thanasipantazides/tate-thermovac/build/tvac-bom-order.xlsx

Designator | Footprint | Quantity | Value | DNP | Manufacturer | MPN | Distributor | DPN
A2 | Hirose_DF40HC(3.0)-100DS-0.4V_2x50_P0.4mm_RPi_CM4-BUS | 1 | Raspberry_Pi_CM4-BUS |  | Hirose | DF40HC(3.0)-100DS-0.4V(58) | Digikey | H124602CT-ND
A3 | Hirose_DF40HC(3.0)-100DS-0.4V_2x50_P0.4mm_RPi_CM4-GPIO | 1 | Raspberry_Pi_CM4-GPIO |  | Hirose | DF40HC(3.0)-100DS-0.4V(58) | Digikey | H124602CT-ND
C2, C28 | C_1210_3225Metric | 2 | 10µF (X5R) |  | YAGEO | CC1210KFX7R8BB106 | Digikey | 13-CC1210KFX7R8BB106CT-ND
C1, C3, C4, C30, C31, C56, C57, C59, C61, C68, C74 | C_0603_1608Metric | 9 | 0.1µF |  | YAGEO | CC0603KRX7R8BB104 | Digikey | 311-1341-1-ND
C5, C32, C54, C70, C71, C75, C76 | C_0603_1608Metric | 7 | 1µF |  | YAGEO | CC0603MRX5R8BB105 | Digikey | 311-1823-1-ND
C6, C33, C58, C64, C65, C66 | C_1210_3225Metric | 6 | 10µF |  | YAGEO | CC1210MKX7R8BB106 | Digikey | 311-3469-1-ND
C7, C29 | C_1210_3225Metric | 2 | 10µF (X7R) |  | YAGEO | CC1210MKX7R8BB106 | Digikey | 311-3469-1-ND
C8, C9, C10, C11, C12, C13, C14, C15, C16, C17, C18, C19, C20, C21, C22, C23, C24, C25, C26, C27, C34, C35, C36, C37, C38, C39, C40, C41, C42, C43, C44, C45, C46, C47, C48, C49, C50, C51, C52, C53 | C_0603_1608Metric | 40 | 100pF |  | YAGEO | CC0603KRX7R8BB101 | Digikey | 311-4078-1-ND
C55 | C_0603_1608Metric | 1 | 1nF |  | YAGEO | CC0603KRX7R9BB102 | Digikey | 311-1080-1-ND
C60 | C_1210_3225Metric | 1 | 100nF, 100V |  | Murata | GRM155R62A104KE14D | Digikey | 490-10458-1-ND
C62 | C_0603_1608Metric | 1 | 4.7pF |  | YAGEO | CC0603CRNPO9BN4R7 | Digikey | 311-1740-1-ND
C63, C69 | C_1210_3225Metric | 2 | 100µF (X5R) |  | Taiyo Yuden | EMK325ABJ107MM-P | Digikey | 587-5426-1-ND
C67 | C_0603_1608Metric | 1 | 330pF |  | YAGEO | CC0603KRX7R9BB331 | Digikey | 311-1186-1-ND
D1 | LED_1206_3216Metric | 1 | GREEN |  | Kingbright | APT3216SGC | Digikey | 754-1141-1-ND
D2 | LED_1206_3216Metric | 1 | RED |  | Kingbright | APT3216SECK/J3-PRV | Digikey | 754-1796-1-ND
D3 | SOT-23 | 1 | MMBZ5242BLT3G |  | onsemi | MMBZ5242BLT3G | Digikey | MMBZ5242BLT3GOSCT-ND
D4 | LED_1206_3216Metric | 1 | YELLOW |  | Kingbright | APTD3216YC | Digikey | 754-1161-1-ND
FB1 | C_1812_4532Metric | 1 | 100Ω @ 1MHz |  | Wuerth | 742792515 | Digikey | 732-1642-1-ND
J2 | microSD_HC_Wuerth_693072010801 | 1 | Micro_SD_Card |  | Wuerth | 693072010801 | Digikey | 732-3820-1-ND
J3 | BarrelJack_Wuerth_6941xx301002 | 1 | Barrel_Jack_Switch | DNP | Wuerth | 694106301002 | Digikey | 732-5930-ND
J4 | USB_Micro-B_Amphenol_10118194-0001LF_Horizontal | 1 | USB_B_Micro |  | Amphenol | 10118194-0001LF | Digikey | 609-4618-1-ND
J5, J6, J8, J9 | PinHeader_1x02_P2.54mm_Vertical | 4 | Conn_01x02 | DNP |  |  | Digikey
J7 | HDMI_A_Amphenol_10029449-x01xLF_Horizontal | 1 | HDMI_A |  | Amphenol | 10029449-001RLF | Digikey | 609-1010-1-ND
J10 | PinHeader_2x14_P2.54mm_Vertical | 1 | Conn_02x14_Odd_Even | DNP |  |  | Digikey
J11 | DSUB-37-Stacked_NorComp-189037313R571 | 1 | 189037313R571 | DNP | NorComp | 189-037-313R571 | Digikey | 1037FME-ND
L1 | L_Wuerth_HCI-1365 | 1 | 1.5µH |  | Wuerth | 744373965015 | Digikey | 732-11438-1-ND
Q1 | TO-252-2 | 1 | AOD4189 |  | Alpha and Omega Semiconductor | AOD4189 | Digikey | 785-1351-1-ND
R1, R2 | R_0603_1608Metric | 2 | 470Ω |  | YAGEO | RC0603FR-07470RL | Digikey | RC0603FR-07470RL
R3, R4 | R_0603_1608Metric | 2 | 1kΩ |  | YAGEO | RC0603FR-071KL | Digikey | 311-1.00KHRCT-ND
R7, R8, R9, R12 | R_0603_1608Metric | 4 | 10kΩ |  | YAGEO | RC0603JR-0710KL | Digikey | 311-10KGRCT-ND
R13 | R_0603_1608Metric | 1 | 511Ω |  | YAGEO | RC0603FR-10511RL | Digikey | 13-RC0603FR-10511RLCT-ND
R14 | R_0603_1608Metric | 1 | 1MΩ 0.5% |  | YAGEO | RT0603DRE071ML | Digikey | 13-RT0603DRE071MLCT-ND
R15 | R_0603_1608Metric | 1 | 243kΩ 0.5% |  | YAGEO | RT0603BRD07243KL | Digikey | 13-RT0603BRD07243KLCT-ND
R16 | R_0603_1608Metric | 1 | 8.45kΩ |  | YAGEO | RT0603BRD078K45L | Digikey | 13-RT0603BRD078K45LCT-ND
R17 | R_0603_1608Metric | 1 | 17.8kΩ 0.5% |  | YAGEO | RT0603BRD0717K8L | Digikey | YAG4482CT-ND
R18, R24, R25, R26, R27 | R_1210_3225Metric | 5 | 0Ω |  | YAGEO | RC1210FR-070RL | Digikey | 13-RC1210FR-070RLCT-ND
R19 | R_0603_1608Metric | 1 | 47kΩ |  | YAGEO | RT0603DRD0747KL | Digikey | 311-47KDCT-ND
R20 | R_0603_1608Metric | 1 | 2.33kΩ 1% |  | YAGEO | RT0603BRD072K32L | Digikey | YAG1617CT-ND
R21 | R_0603_1608Metric | 1 | 133Ω |  | YAGEO | RC0603FR-07133RL | Digikey | 311-133HRCT-ND
R22, R23 | R_0603_1608Metric | 2 | 2.2kΩ 1% |  | YAGEO | RC0603FR-072K2L | Digikey | 311-2.20KHRCT-ND
R10, RSENSE1, RSENSE2 | R_0603_1608Metric | 2 | 12kΩ <0.5% |  | YAGEO | RT0603DRD0712KL | Digikey | 311-12KDCT-ND
SW1 | PinSocket_2x03_P2.54mm_Vertical | 1 | MNL12LC | DNP |  |  | Digikey
SW2, SW4 | SW_DIP_SPSTx01_Slide_9.78x4.72mm_W7.62mm_P2.54mm | 2 | FSM5JA | DNP |  |  | Digikey
SW3 | SW_PUSH_6mm | 1 | FSM5JA | DNP |  |  | Digikey
TP1, TP3, TP4, TP5, TP6, TP7, TP8, TP10, TP11 | TestPoint_Pad_D2.5mm | 9 | TestPoint | DNP |  |  | Digikey
TP9 | TestPoint_Pad_D2.5mm | 1 | OTG | DNP |  |  | Digikey
U1, U5 | LQFP-48_7x7mm_P0.5mm | 2 | LTC2983 |  | Analog Devices | LTC2983 | Digikey | 505-LTC2983CLX#PBF-ND
U2 | SOT-23-3 | 1 | RT9742SNGV |  | Richtek | RT9742SNGV | Digikey | 1028-RT9742SNGVCT-ND
U3 | RJ45_Abracon_ARJM11C7-502-AB | 1 | ARJM11C7-502-AB | DNP |  |  | Digikey
U4 | SOT-23-5 | 1 | 74LVC1G07 |  | Texas Instruments | SN74LVC1G07DBVR | Digikey | 296-8485-1-ND
U6 | LFCSP-32-1EP_5x5mm_P0.5mm_EP3.5x3.5mm | 1 | AD7490BCPZ |  | Analog Devices | AD7490BCPZ | Digikey | 505-AD7490BCPZ-ND
U7 | SOIC-8_3.9x4.9mm_P1.27mm | 1 | AD780 |  | Analog Devices | AD780ARZ | Digikey | AD780ARZ-REEL7CT-ND
U8 | QFN-24-1EP_4x4mm_P0.5mm_EP2.75x2.75mm | 1 | LT8643S |  | Analog Devices | LT8643S | Digikey | LT8643S
U9 | WSON-8-1EP_2x2mm_P0.5mm_EP0.9x1.6mm | 1 | TPS2595x0/1 |  | Texas Instruments | TPS259530DSGR | Digikey | 296-51893-1-ND
U10 | SOT-323_SC-70 | 1 | TPD2E2U06DCK |  | Texas Instruments | TPD2E2U06DCKR | Digikey | 296-TPD2E2U06DCKRCT-ND
U11 | DHWQFN-14-1EP_2.5x3mm_P0.5mm_EP1x1.5mm | 1 | FXL5T244BQX |  | onsemi | FXL5T244BQX | Digikey | FXL5T244BQXCT-ND
