thanasipantazides/tate-thermovac/tvac.kicad_pcb

## KiCad design tvac.kicad_pcb (2026-11-06)

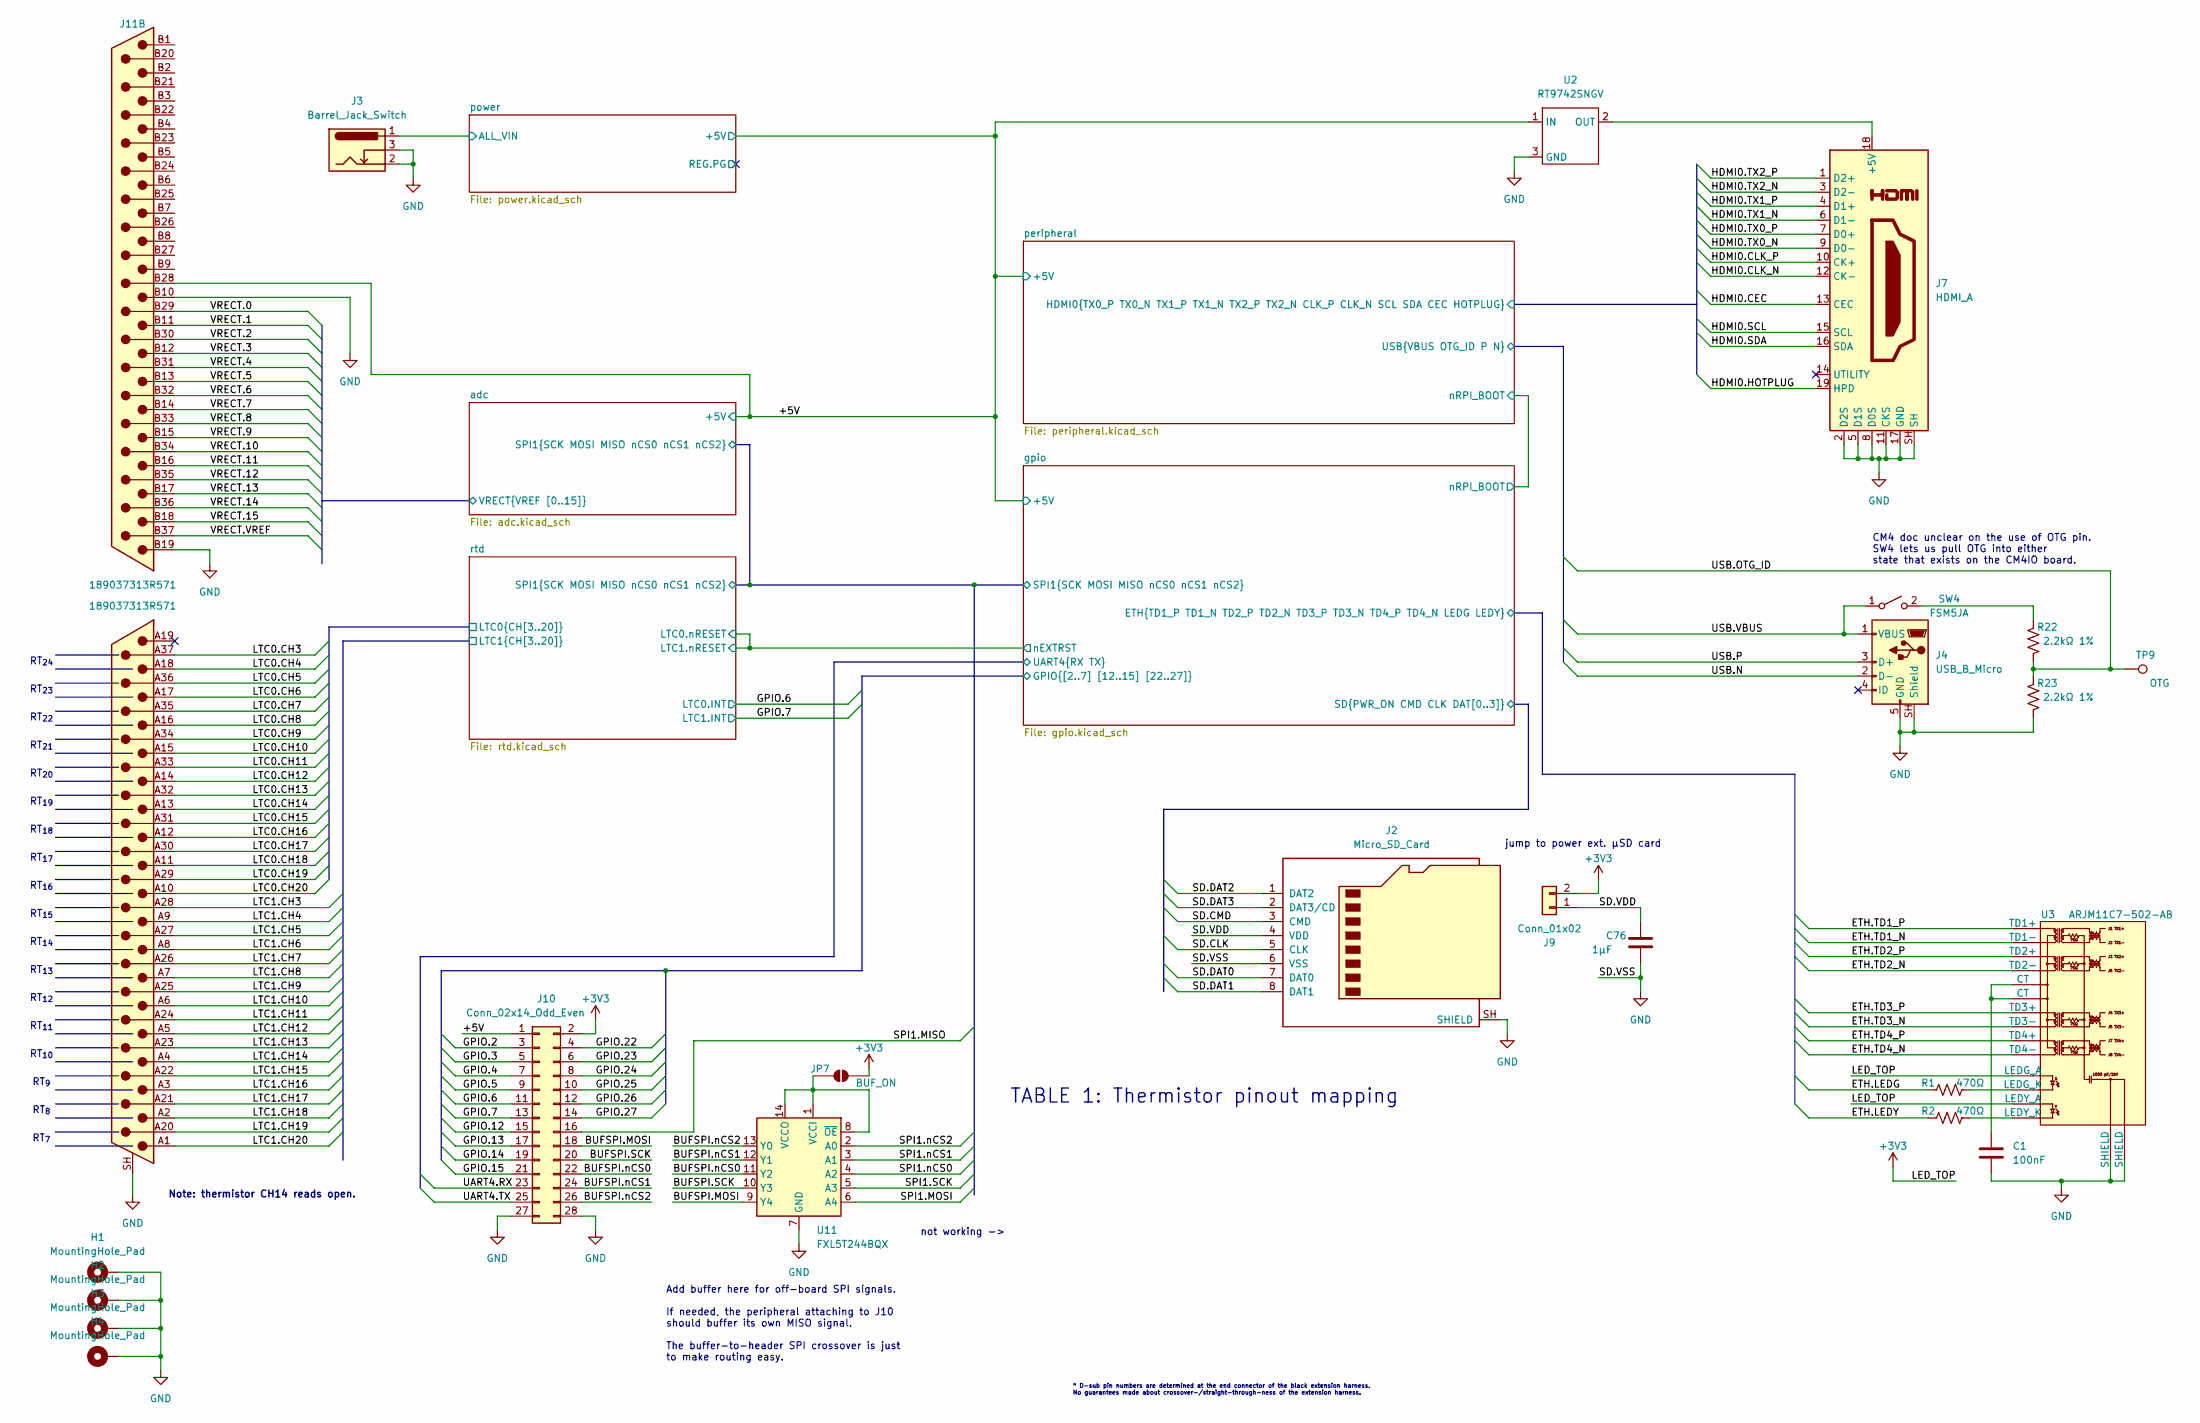
[picture p1: schematic tvac.kicad_sch, the Thermovac Sensation]

Parts:
C1: 100nF; C_0603_1608Metric
C76: 1µF; C_0603_1608Metric
H1, H2, H3, H4: MountingHole_Pad; MountingHole_4.3mm_M4_DIN965_Pad
J2: Micro_SD_Card; microSD_HC_Wuerth_693072010801
J3: Barrel_Jack_Switch; BarrelJack_Wuerth_6941xx301002; Digikey 732-5930-ND
J4: USB_B_Micro; USB_Micro-B_Amphenol_10118194-0001LF_Horizontal; Digikey 609-4618-1-ND
J7: HDMI_A; HDMI_A_Amphenol_10029449-x01xLF_Horizontal; Digikey 609-1010-1-ND
J9: Conn_01x02; PinHeader_1x02_P2.54mm_Vertical
J10: Conn_02x14_Odd_Even; PinHeader_2x14_P2.54mm_Vertical
J11: 189037313R571; DSUB-37-Stacked_NorComp-189037313R571
JP7: BUF_ON; SolderJumper-2_P1.3mm_Open_RoundedPad1.0x1.5mm
R1, R2: 470Ω; R_0603_1608Metric
R22, R23: 2.2kΩ 1%; R_0603_1608Metric
SW4: FSM5JA; SW_DIP_SPSTx01_Slide_9.78x4.72mm_W7.62mm_P2.54mm
TP9: OTG; TestPoint_Pad_D2.5mm
U2: RT9742SNGV; SOT-23-3
U3: ARJM11C7-502-AB; RJ45_Abracon_ARJM11C7-502-AB
U11: FXL5T244BQX; DHWQFN-14-1EP_2.5x3mm_P0.5mm_EP1x1.5mm

Connections:
+3V3: J9.2, J10.2, JP7.2 (B), U3.P11 (LEDG_A), U3.P13 (LEDY_A); also elsewhere on the board
/+5V: J10.1, J11.B28 (28), U2.1 (IN); also elsewhere on the board
/BUFSPI.MOSI: J10.18, U11.9 (Y4)
/BUFSPI.SCK: J10.20, U11.10 (Y3)
/BUFSPI.nCS0: J10.22, U11.11 (Y2)
/BUFSPI.nCS1: J10.24, U11.12 (Y1)
/BUFSPI.nCS2: J10.26, U11.13 (Y0)
/SD.VDD: C76.1, J2.4 (VDD), J9.1
/adc/SPI1.MISO: J10.16; also elsewhere on the board
/adc/SPI1.MOSI: U11.6 (A4); also elsewhere on the board
/adc/SPI1.SCK: U11.5 (A3); also elsewhere on the board
/adc/SPI1.nCS0: U11.4 (A2); also elsewhere on the board
/adc/SPI1.nCS1: U11.3 (A1); also elsewhere on the board
/adc/SPI1.nCS2: U11.2 (A0); also elsewhere on the board
/adc/VRECT.0: J11.B29 (29); also elsewhere on the board
/adc/VRECT.1: J11.B11 (11); also elsewhere on the board
/adc/VRECT.2: J11.B30 (30); also elsewhere on the board
/adc/VRECT.3: J11.B12 (12); also elsewhere on the board
/adc/VRECT.4: J11.B31 (31); also elsewhere on the board
/adc/VRECT.5: J11.B13 (13); also elsewhere on the board
/adc/VRECT.6: J11.B32 (32); also elsewhere on the board
/adc/VRECT.7: J11.B14 (14); also elsewhere on the board
/adc/VRECT.8: J11.B33 (33); also elsewhere on the board
/adc/VRECT.9: J11.B15 (15); also elsewhere on the board
/adc/VRECT.10: J11.B34 (34); also elsewhere on the board
/adc/VRECT.11: J11.B16 (16); also elsewhere on the board
/adc/VRECT.12: J11.B35 (35); also elsewhere on the board
/adc/VRECT.13: J11.B17 (17); also elsewhere on the board
/adc/VRECT.14: J11.B36 (36); also elsewhere on the board
/adc/VRECT.15: J11.B18 (18); also elsewhere on the board
/adc/VRECT.VREF: J11.B37 (37); also elsewhere on the board
/gpio/ETH.LEDG: R1.1; also elsewhere on the board
/gpio/ETH.LEDY: R2.1; also elsewhere on the board
/gpio/ETH.TD1_N: U3.P2 (TD1-); also elsewhere on the board
/gpio/ETH.TD1_P: U3.P1 (TD1+); also elsewhere on the board
/gpio/ETH.TD2_N: U3.P4 (TD2-); also elsewhere on the board
/gpio/ETH.TD2_P: U3.P3 (TD2+); also elsewhere on the board
/gpio/ETH.TD3_N: U3.P8 (TD3-); also elsewhere on the board
/gpio/ETH.TD3_P: U3.P7 (TD3+); also elsewhere on the board
/gpio/ETH.TD4_N: U3.P10 (TD4-); also elsewhere on the board
/gpio/ETH.TD4_P: U3.P9 (TD4+); also elsewhere on the board
/gpio/GPIO.2: J10.3; also elsewhere on the board
/gpio/GPIO.3: J10.5; also elsewhere on the board
/gpio/GPIO.4: J10.7; also elsewhere on the board
/gpio/GPIO.5: J10.9; also elsewhere on the board
/gpio/GPIO.6: J10.11; also elsewhere on the board
/gpio/GPIO.7: J10.13; also elsewhere on the board
/gpio/GPIO.12: J10.15; also elsewhere on the board
/gpio/GPIO.13: J10.17; also elsewhere on the board
/gpio/GPIO.14: J10.19; also elsewhere on the board
/gpio/GPIO.15: J10.21; also elsewhere on the board
/gpio/GPIO.22: J10.4; also elsewhere on the board
/gpio/GPIO.23: J10.6; also elsewhere on the board
/gpio/GPIO.24: J10.8; also elsewhere on the board
/gpio/GPIO.25: J10.10; also elsewhere on the board
/gpio/GPIO.26: J10.12; also elsewhere on the board
/gpio/GPIO.27: J10.14; also elsewhere on the board
/gpio/SD.CLK: J2.5 (CLK); also elsewhere on the board
/gpio/SD.CMD: J2.3 (CMD); also elsewhere on the board
/gpio/SD.DAT0: J2.7 (DAT0); also elsewhere on the board
/gpio/SD.DAT1: J2.8 (DAT1); also elsewhere on the board
/gpio/SD.DAT2: J2.1 (DAT2); also elsewhere on the board
/gpio/SD.DAT3: J2.2 (DAT3/CD); also elsewhere on the board
/gpio/UART4.RX: J10.23; also elsewhere on the board
/gpio/UART4.TX: J10.25; also elsewhere on the board
/peripheral/HDMI0.CEC: J7.13 (CEC); also elsewhere on the board
/peripheral/HDMI0.CLK_N: J7.12 (CK-); also elsewhere on the board
/peripheral/HDMI0.CLK_P: J7.10 (CK+); also elsewhere on the board
/peripheral/HDMI0.HOTPLUG: J7.19 (HPD); also elsewhere on the board
/peripheral/HDMI0.SCL: J7.15 (SCL); also elsewhere on the board
/peripheral/HDMI0.SDA: J7.16 (SDA); also elsewhere on the board
/peripheral/HDMI0.TX0_N: J7.9 (D0-); also elsewhere on the board
/peripheral/HDMI0.TX0_P: J7.7 (D0+); also elsewhere on the board
/peripheral/HDMI0.TX1_N: J7.6 (D1-); also elsewhere on the board
/peripheral/HDMI0.TX1_P: J7.4 (D1+); also elsewhere on the board
/peripheral/HDMI0.TX2_N: J7.3 (D2-); also elsewhere on the board
/peripheral/HDMI0.TX2_P: J7.1 (D2+); also elsewhere on the board
/peripheral/USB.N: J4.2 (D-); also elsewhere on the board
/peripheral/USB.OTG_ID: R22.2, R23.1, TP9.1 (1_1); also elsewhere on the board
/peripheral/USB.P: J4.3 (D+); also elsewhere on the board
/peripheral/USB.VBUS: J4.1 (VBUS), SW4.1 (A); also elsewhere on the board
/power/ALL_VIN: J3.1; also elsewhere on the board
/rtd/LTC0.CH4: J11.A18 (18); also elsewhere on the board
/rtd/LTC0.CH6: J11.A17 (17); also elsewhere on the board
/rtd/LTC0.CH8: J11.A16 (16); also elsewhere on the board
/rtd/LTC0.CH9: J11.A29 (29), J11.A30 (30), J11.A31 (31), J11.A32 (32), J11.A33 (33), J11.A34 (34), J11.A35 (35), J11.A36 (36), J11.A37 (37); also elsewhere on the board
/rtd/LTC0.CH10: J11.A15 (15); also elsewhere on the board
/rtd/LTC0.CH12: J11.A14 (14); also elsewhere on the board
/rtd/LTC0.CH14: J11.A13 (13); also elsewhere on the board
/rtd/LTC0.CH16: J11.A12 (12); also elsewhere on the board
/rtd/LTC0.CH18: J11.A11 (11); also elsewhere on the board
/rtd/LTC0.CH20: J11.A10 (10); also elsewhere on the board
/rtd/LTC1.CH4: J11.A9 (9); also elsewhere on the board
/rtd/LTC1.CH6: J11.A8 (8); also elsewhere on the board
/rtd/LTC1.CH8: J11.A7 (7); also elsewhere on the board
/rtd/LTC1.CH9: J11.A20 (20), J11.A21 (21), J11.A22 (22), J11.A23 (23), J11.A24 (24), J11.A25 (25), J11.A26 (26), J11.A27 (27), J11.A28 (28); also elsewhere on the board
/rtd/LTC1.CH10: J11.A6 (6); also elsewhere on the board
/rtd/LTC1.CH12: J11.A5 (5); also elsewhere on the board
/rtd/LTC1.CH14: J11.A4 (4); also elsewhere on the board
/rtd/LTC1.CH16: J11.A3 (3); also elsewhere on the board
/rtd/LTC1.CH18: J11.A2 (2); also elsewhere on the board
/rtd/LTC1.CH20: J11.A1 (1); also elsewhere on the board
GND: C1.2, C76.2, H1.1 (1_1), H2.1 (1_1), H3.1 (1_1), H4.1 (1_1), J2.6 (VSS), J2.SH (SHIELD), J3.2, J3.3, J4.5 (GND), J4.SH (Shield), J7.2 (D2S), J7.5 (D1S), J7.8 (D0S), J7.11 (CKS), J7.17 (GND), J7.SH, J10.27, J10.28, J11.B10 (10), J11.B19 (19), J11.SH (PAD), R23.2, U2.3 (GND), U3.H1 (SHIELD), U3.H2 (SHIELD), U11.7 (GND); also elsewhere on the board
unnamed: C1.1, U3.P5 (CT), U3.P6 (CT)
unnamed: J7.18 (+5V), U2.2 (OUT)
unnamed: JP7.1 (A), U11.1 (VCCI), U11.8 (~OE), U11.14 (VCCO)
unnamed: R22.1, SW4.2 (B)
unnamed: R1.2, U3.P12 (LEDG_K)
unnamed: R2.2, U3.P14 (LEDY_K)

Notes on the sheet:
RT_{8}
RT_{23}
jump to power ext. µSD card
RT_{12}
RT_{24}
RT_{17}
Note: thermistor CH14 reads open.
RT_{16}
RT_{11}
RT_{7}
RT_{20}
RT_{22}
TABLE 1: Thermistor pinout mapping
RT_{9}
RT_{13}
RT_{21}
RT_{19}
not working ->
* D-sub pin numbers are determined at the end connector of the black extension harness. No guarantees made about crossover-/straight-through-ness of the extension harness.
Add buffer here for off-board SPI signals. If needed, the peripheral attaching to J10 should buffer its own MISO signal. The buffer-to-header SPI crossover is just to make routing easy.
RT_{14}
RT_{18}
RT_{15}
CM4 doc unclear on the use of OTG pin. SW4 lets us pull OTG into either state that exists on the CM4IO board.
RT_{10}

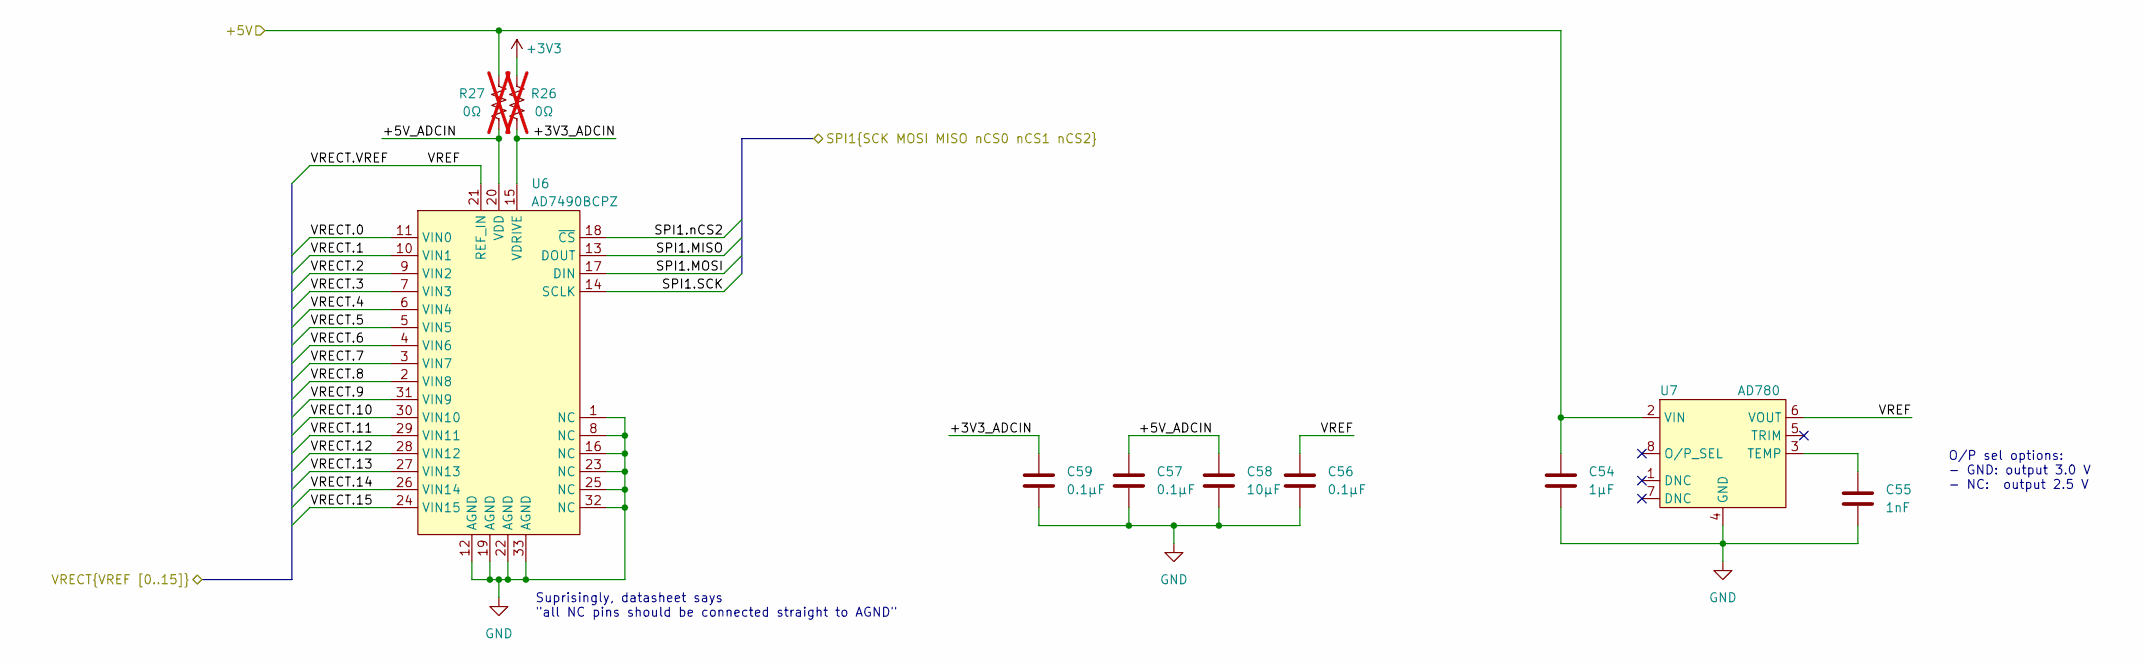
[picture p2: schematic adc.kicad_sch, the Thermovac Sensation]

Parts:
C54: 1µF; C_0603_1608Metric
C55: 1nF; C_0603_1608Metric
C56, C57, C59: 0.1µF; C_0603_1608Metric
C58: 10µF; C_1210_3225Metric
R26, R27: 0Ω; R_1210_3225Metric; not fitted
U6: AD7490BCPZ; LFCSP-32-1EP_5x5mm_P0.5mm_EP3.5x3.5mm; Digikey 505-AD7490BCPZ-ND
U7: AD780; SOIC-8_3.9x4.9mm_P1.27mm; Digikey 505-AD780ARZ-ND

Connections:
+3V3: R26.2; also elsewhere on the board
/+5V: C54.1, R27.2, U7.2 (VIN); also elsewhere on the board
/adc/+3V3_ADCIN: C59.1, R26.1, U6.15 (VDRIVE)
/adc/+5V_ADCIN: C57.1, C58.1, R27.1, U6.20 (VDD)
/adc/SPI1.MISO: U6.13 (DOUT); also elsewhere on the board
/adc/SPI1.MOSI: U6.17 (DIN); also elsewhere on the board
/adc/SPI1.SCK: U6.14 (SCLK); also elsewhere on the board
/adc/SPI1.nCS2: U6.18 (~CS); also elsewhere on the board
/adc/VRECT.0: U6.11 (VIN0); also elsewhere on the board
/adc/VRECT.1: U6.10 (VIN1); also elsewhere on the board
/adc/VRECT.2: U6.9 (VIN2); also elsewhere on the board
/adc/VRECT.3: U6.7 (VIN3); also elsewhere on the board
/adc/VRECT.4: U6.6 (VIN4); also elsewhere on the board
/adc/VRECT.5: U6.5 (VIN5); also elsewhere on the board
/adc/VRECT.6: U6.4 (VIN6); also elsewhere on the board
/adc/VRECT.7: U6.3 (VIN7); also elsewhere on the board
/adc/VRECT.8: U6.2 (VIN8); also elsewhere on the board
/adc/VRECT.9: U6.31 (VIN9); also elsewhere on the board
/adc/VRECT.10: U6.30 (VIN10); also elsewhere on the board
/adc/VRECT.11: U6.29 (VIN11); also elsewhere on the board
/adc/VRECT.12: U6.28 (VIN12); also elsewhere on the board
/adc/VRECT.13: U6.27 (VIN13); also elsewhere on the board
/adc/VRECT.14: U6.26 (VIN14); also elsewhere on the board
/adc/VRECT.15: U6.24 (VIN15); also elsewhere on the board
/adc/VRECT.VREF: C56.1, U6.21 (REF_IN), U7.6 (VOUT); also elsewhere on the board
GND: C54.2, C55.2, C56.2, C57.2, C58.2, C59.2, U6.1 (NC), U6.8 (NC), U6.12 (AGND), U6.16 (NC), U6.19 (AGND), U6.22 (AGND), U6.23 (NC), U6.25 (NC), U6.32 (NC), U6.33 (AGND), U7.4 (GND); also elsewhere on the board
unnamed: C55.1, U7.3 (TEMP)

Notes on the sheet:
O/P sel options: - GND: output 3.0 V - NC: output 2.5 V
Suprisingly, datasheet says "all NC pins should be connected straight to AGND"

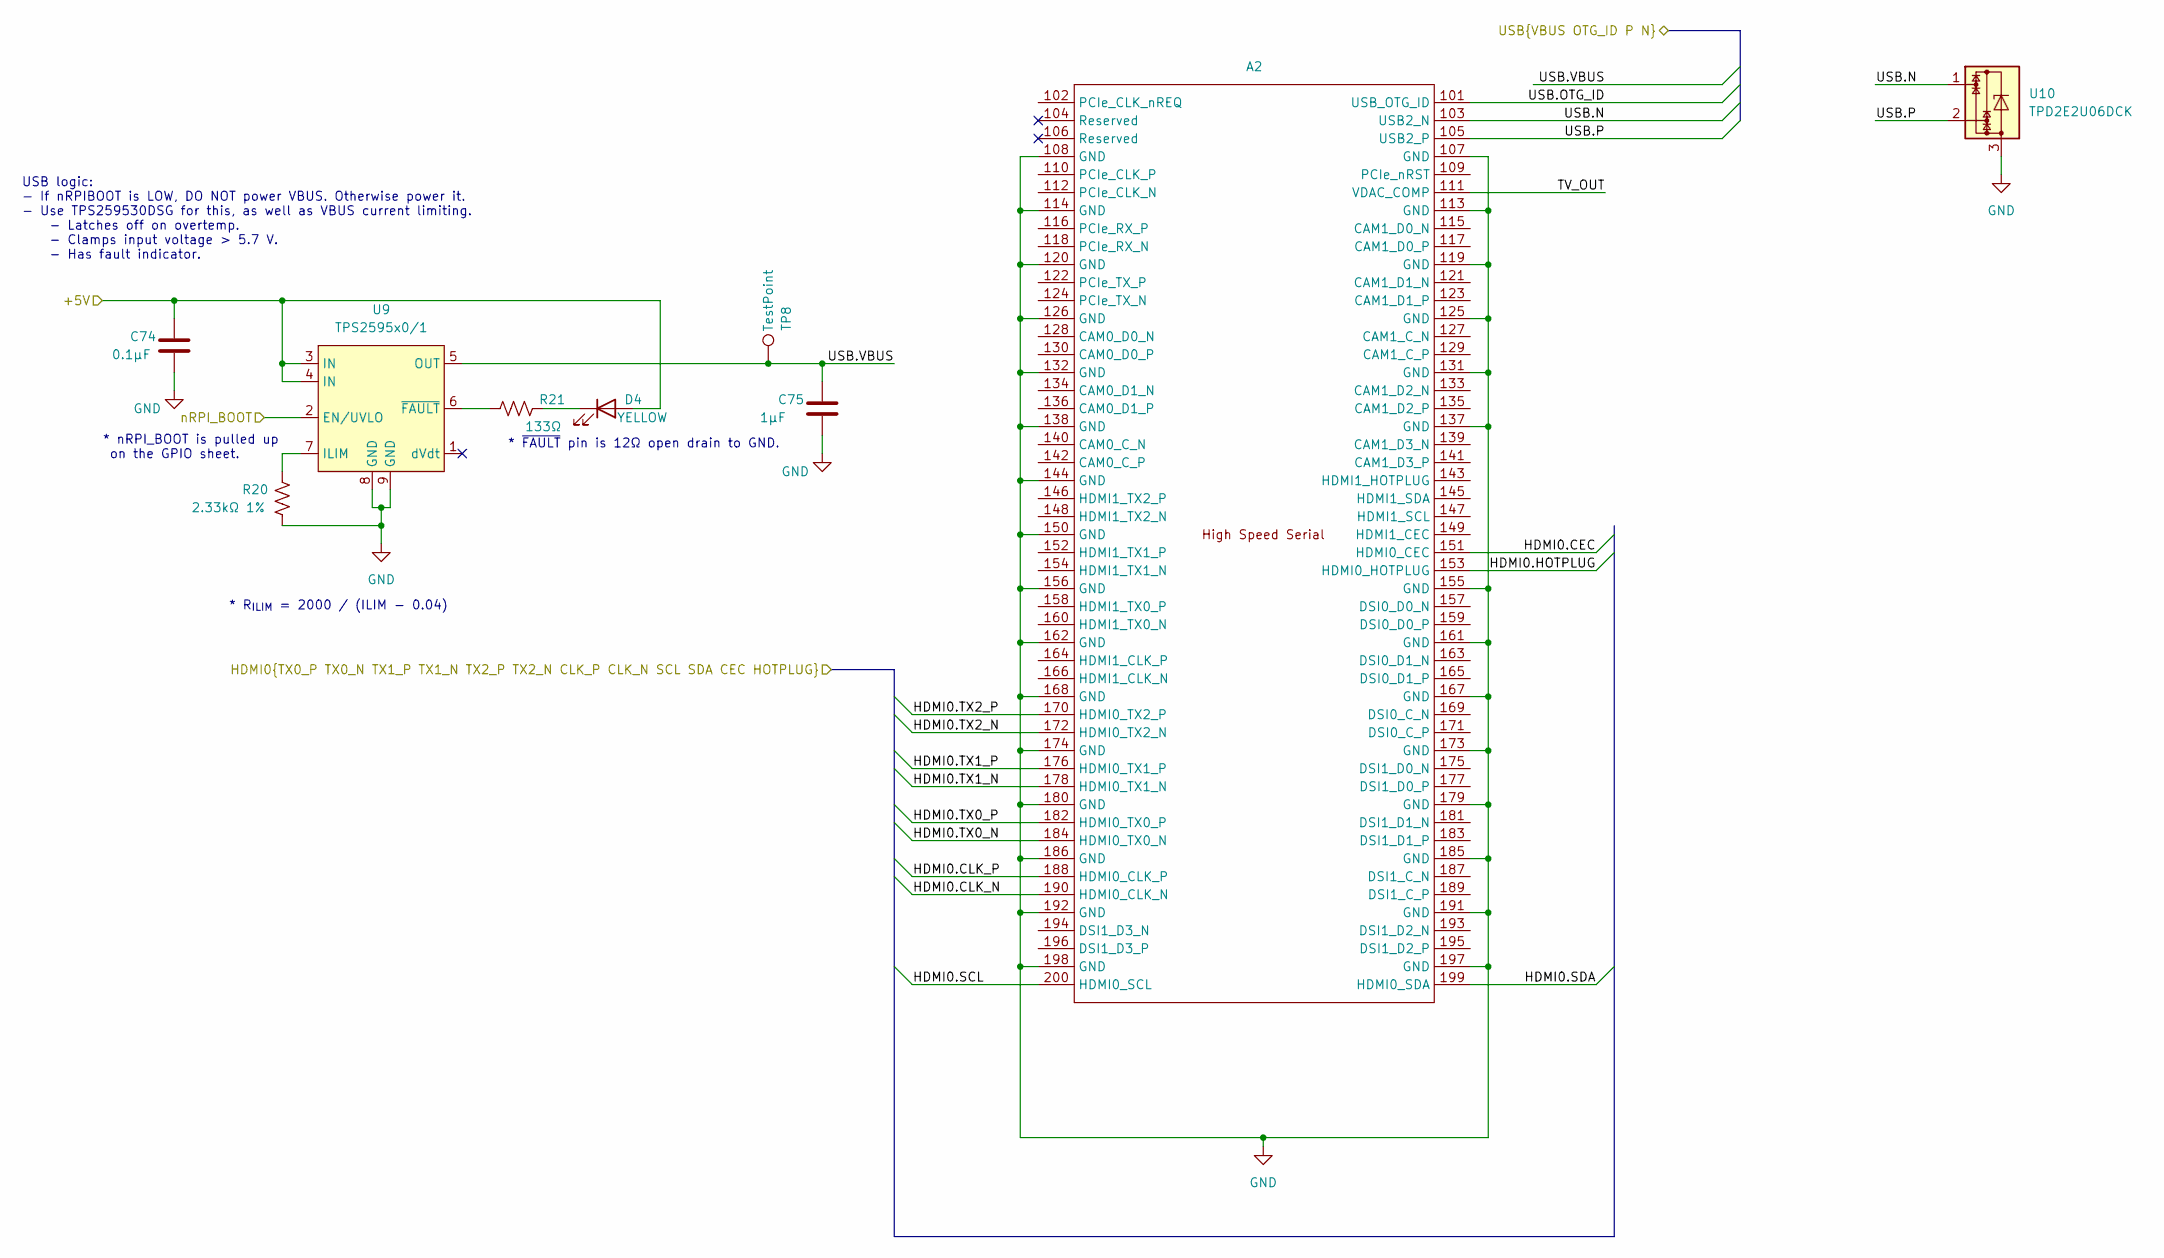
[picture p3: schematic peripheral.kicad_sch, the Thermovac Sensation]

Parts:
A2: Hirose_DF40HC(3.0)-100DS-0.4V_2x50_P0.4mm_RPi_CM4-BUS
C74: 0.1µF; C_0603_1608Metric
C75: 1µF; C_0603_1608Metric
D4: YELLOW; LED_1206_3216Metric; Digikey 160-1406-1-ND
R20: 2.33kΩ 1%; R_0603_1608Metric
R21: 133Ω; R_0603_1608Metric
TP8: TestPoint; TestPoint_Pad_D2.5mm
U9: TPS2595x0/1; WSON-8-1EP_2x2mm_P0.5mm_EP0.9x1.6mm
U10: TPD2E2U06DCK; SOT-323_SC-70

Connections:
/+5V: C74.1, D4.2 (A), U9.3 (IN), U9.4 (IN); also elsewhere on the board
/gpio/nRPI_BOOT: U9.2 (EN/UVLO); also elsewhere on the board
/peripheral/HDMI0.CEC: A2.151 (HDMI0_CEC); also elsewhere on the board
/peripheral/HDMI0.CLK_N: A2.190 (HDMI0_CLK_N); also elsewhere on the board
/peripheral/HDMI0.CLK_P: A2.188 (HDMI0_CLK_P); also elsewhere on the board
/peripheral/HDMI0.HOTPLUG: A2.153 (HDMI0_HOTPLUG); also elsewhere on the board
/peripheral/HDMI0.SCL: A2.200 (HDMI0_SCL); also elsewhere on the board
/peripheral/HDMI0.SDA: A2.199 (HDMI0_SDA); also elsewhere on the board
/peripheral/HDMI0.TX0_N: A2.184 (HDMI0_TX0_N); also elsewhere on the board
/peripheral/HDMI0.TX0_P: A2.182 (HDMI0_TX0_P); also elsewhere on the board
/peripheral/HDMI0.TX1_N: A2.178 (HDMI0_TX1_N); also elsewhere on the board
/peripheral/HDMI0.TX1_P: A2.176 (HDMI0_TX1_P); also elsewhere on the board
/peripheral/HDMI0.TX2_N: A2.172 (HDMI0_TX2_N); also elsewhere on the board
/peripheral/HDMI0.TX2_P: A2.170 (HDMI0_TX2_P); also elsewhere on the board
/peripheral/TV_OUT: A2.111 (VDAC_COMP)
/peripheral/USB.N: A2.103 (USB2_N), U10.1; also elsewhere on the board
/peripheral/USB.OTG_ID: A2.101 (USB_OTG_ID); also elsewhere on the board
/peripheral/USB.P: A2.105 (USB2_P), U10.2; also elsewhere on the board
/peripheral/USB.VBUS: C75.1, TP8.1 (1_1), U9.5 (OUT); also elsewhere on the board
GND: A2.107 (GND), A2.108 (GND), A2.113 (GND), A2.114 (GND), A2.119 (GND), A2.120 (GND), A2.125 (GND), A2.126 (GND), A2.131 (GND), A2.132 (GND), A2.137 (GND), A2.138 (GND), A2.144 (GND), A2.150 (GND), A2.155 (GND), A2.156 (GND), A2.161 (GND), A2.162 (GND), A2.167 (GND), A2.168 (GND), A2.173 (GND), A2.174 (GND), A2.179 (GND), A2.180 (GND), A2.185 (GND), A2.186 (GND), A2.191 (GND), A2.192 (GND), A2.197 (GND), A2.198 (GND), C74.2, C75.2, R20.1, U9.8 (GND), U9.9 (GND), U10.3; also elsewhere on the board
unnamed: D4.1 (K), R21.1
unnamed: R20.2, U9.7 (ILIM)
unnamed: R21.2, U9.6 (~FAULT)

Notes on the sheet:
USB logic: - If nRPIBOOT is LOW, DO NOT power VBUS. Otherwise power it. - Use TPS259530DSG for this, as well as VBUS current limiting. - Latches off on overtemp. - Clamps input voltage > 5.7 V. - Has fault indicator.
* R_{ILIM} = 2000 / (ILIM - 0.04)
* nRPI_BOOT is pulled up on the GPIO sheet.
* ~{FAULT} pin is 12Ω open drain to GND.

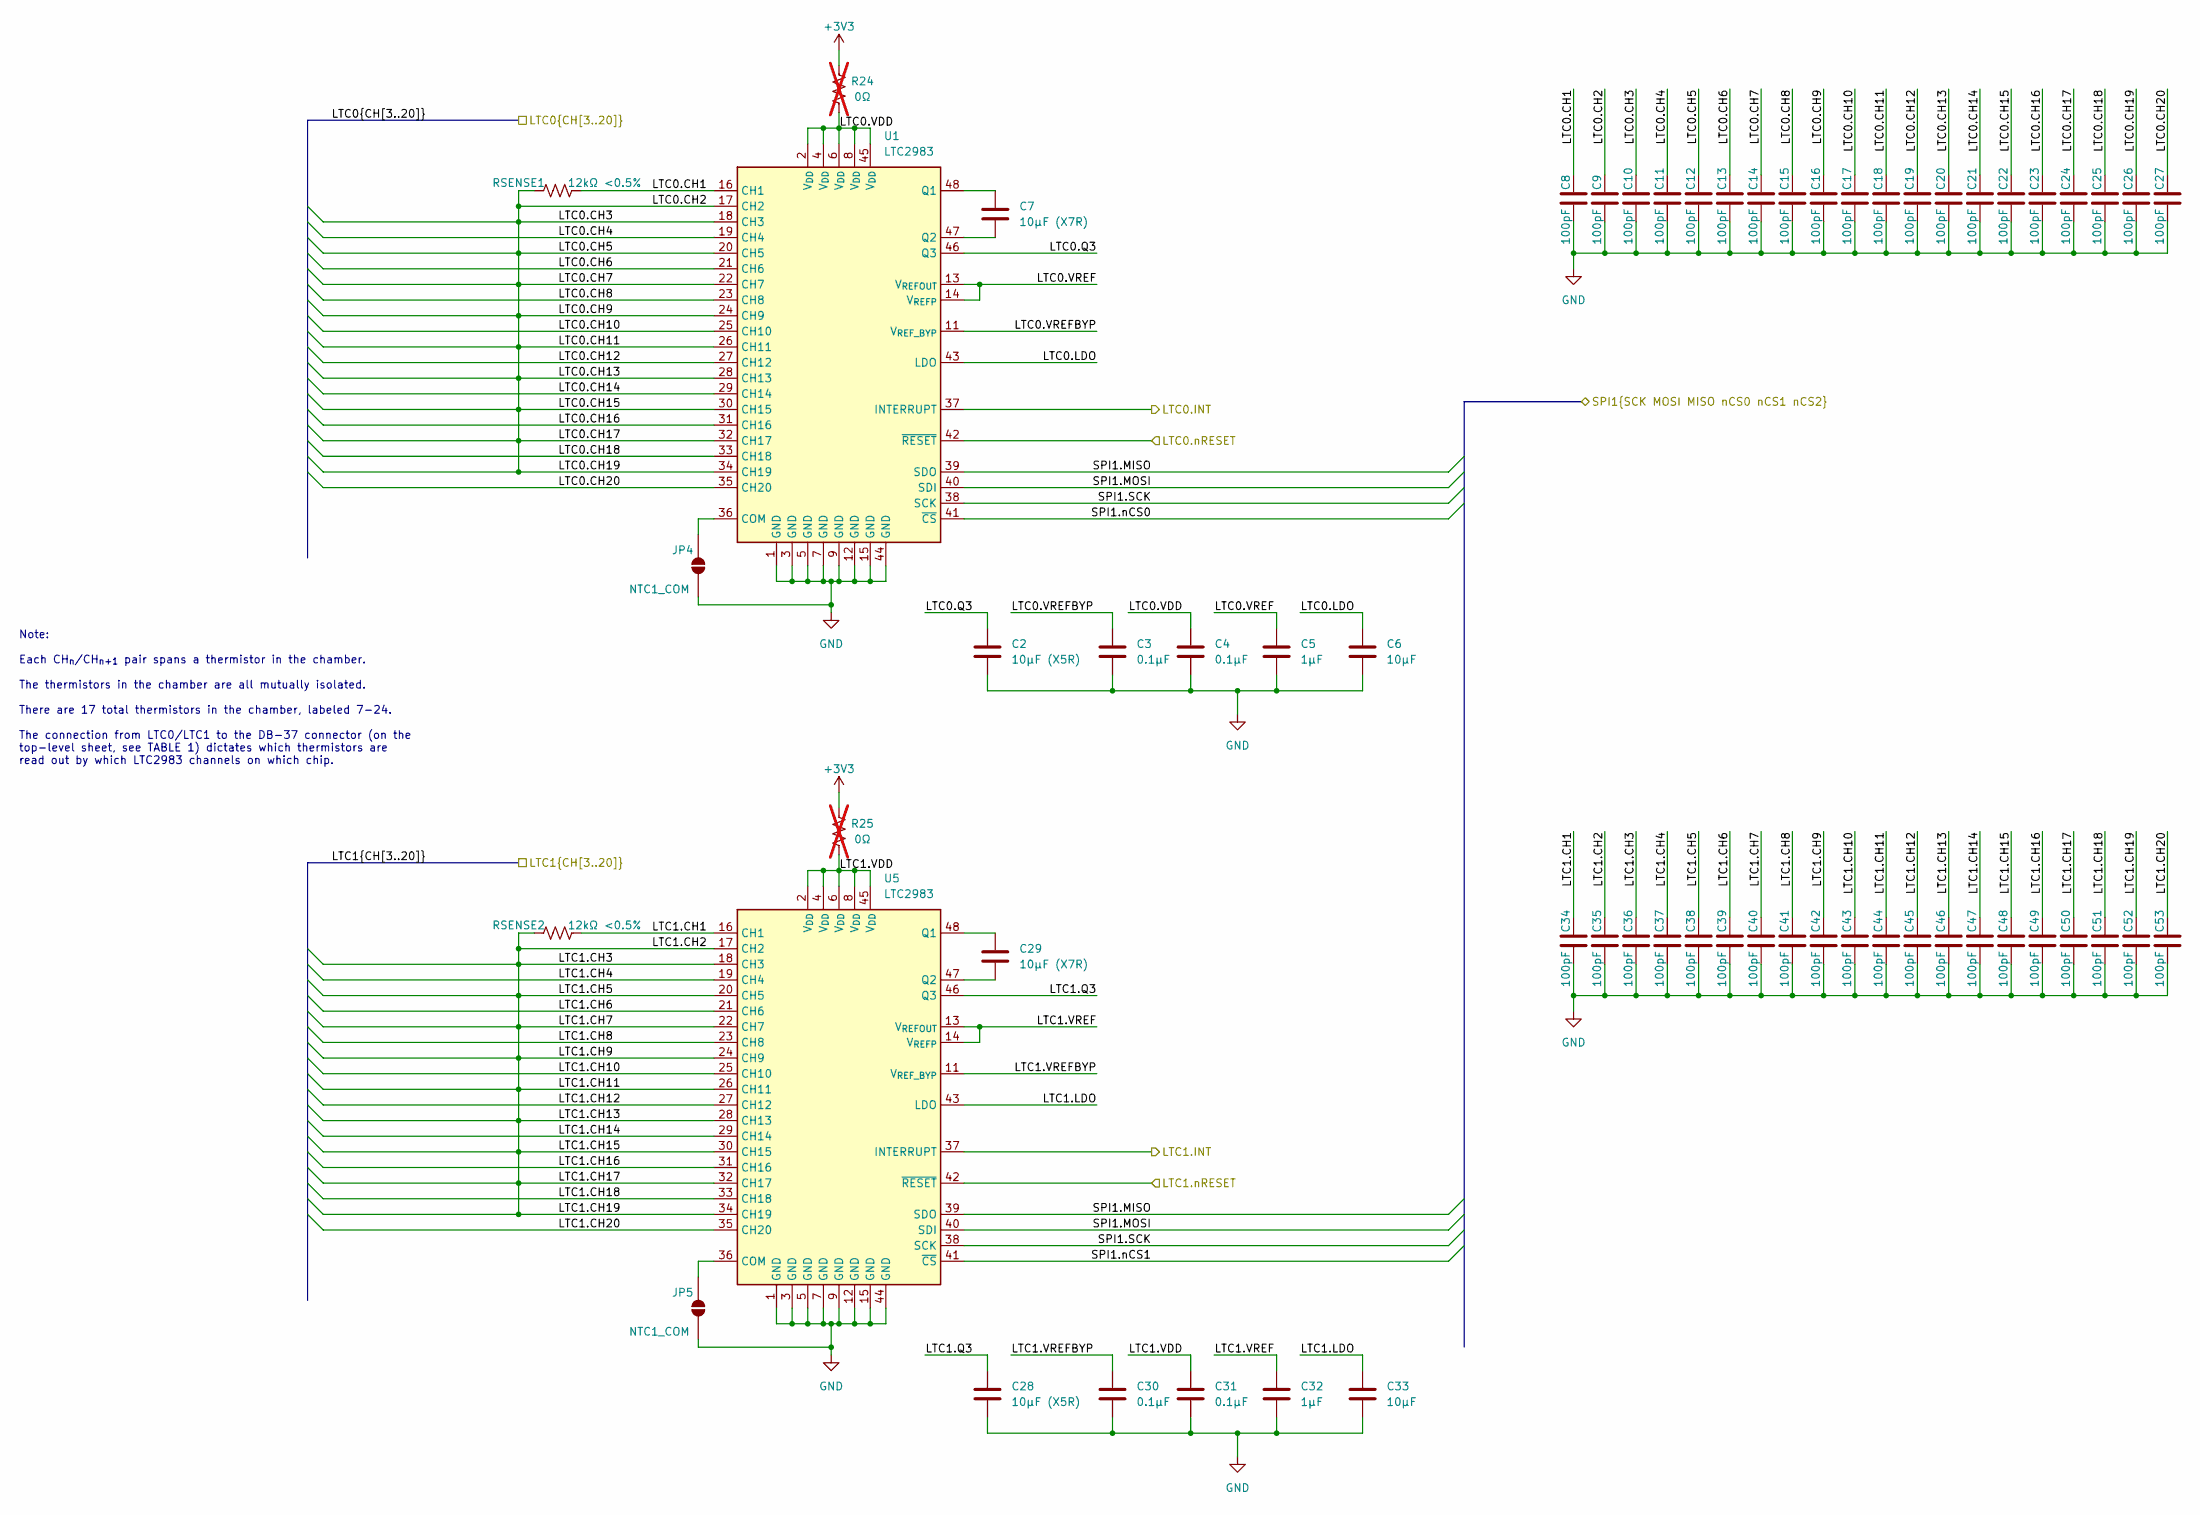
[picture p4: schematic rtd.kicad_sch, the Thermovac Sensation]

Parts:
C2, C28: 10µF (X5R); C_1210_3225Metric
C3, C4, C30, C31: 0.1µF; C_0603_1608Metric
C5, C32: 1µF; C_0603_1608Metric
C6, C33: 10µF; C_1210_3225Metric
C7, C29: 10µF (X7R); C_1210_3225Metric
C8, C9, C10, C11, C12, C13, C14, C15, C16, C17, C18, C19, C20, C21, C22, C23, C24, C25, C26, C27, C34, C35, C36, C37, C38, C39, C40, C41, C42, C43, C44, C45, C46, C47, C48, C49, C50, C51, C52, C53: 100pF; C_0603_1608Metric
JP4, JP5: NTC1_COM; SolderJumper-2_P1.3mm_Open_RoundedPad1.0x1.5mm
R24, R25: 0Ω; R_1210_3225Metric; not fitted
RSENSE1, RSENSE2: 12kΩ <0.5%; R_0603_1608Metric
U1, U5: LTC2983; LQFP-48_7x7mm_P0.5mm

Connections:
+3V3: R24.2, R25.2; also elsewhere on the board
/adc/SPI1.MISO: U1.39 (SDO), U5.39 (SDO); also elsewhere on the board
/adc/SPI1.MOSI: U1.40 (SDI), U5.40 (SDI); also elsewhere on the board
/adc/SPI1.SCK: U1.38 (SCK), U5.38 (SCK); also elsewhere on the board
/adc/SPI1.nCS0: U1.41 (~CS); also elsewhere on the board
/adc/SPI1.nCS1: U5.41 (~CS); also elsewhere on the board
/gpio/GPIO.6: U1.37 (INTERRUPT); also elsewhere on the board
/gpio/GPIO.7: U5.37 (INTERRUPT); also elsewhere on the board
/gpio/nEXTRST: U1.42 (~RESET), U5.42 (~RESET); also elsewhere on the board
/rtd/LTC0.CH1: C8.1, RSENSE1.2, U1.16 (CH1)
/rtd/LTC0.CH4: C11.1, U1.19 (CH4); also elsewhere on the board
/rtd/LTC0.CH6: C13.1, U1.21 (CH6); also elsewhere on the board
/rtd/LTC0.CH8: C15.1, U1.23 (CH8); also elsewhere on the board
/rtd/LTC0.CH9: C9.1, C10.1, C12.1, C14.1, C16.1, C18.1, C20.1, C22.1, C24.1, C26.1, RSENSE1.1, U1.17 (CH2), U1.18 (CH3), U1.20 (CH5), U1.22 (CH7), U1.24 (CH9), U1.26 (CH11), U1.28 (CH13), U1.30 (CH15), U1.32 (CH17), U1.34 (CH19); also elsewhere on the board
/rtd/LTC0.CH10: C17.1, U1.25 (CH10); also elsewhere on the board
/rtd/LTC0.CH12: C19.1, U1.27 (CH12); also elsewhere on the board
/rtd/LTC0.CH14: C21.1, U1.29 (CH14); also elsewhere on the board
/rtd/LTC0.CH16: C23.1, U1.31 (CH16); also elsewhere on the board
/rtd/LTC0.CH18: C25.1, U1.33 (CH18); also elsewhere on the board
/rtd/LTC0.CH20: C27.1, U1.35 (CH20); also elsewhere on the board
/rtd/LTC0.LDO: C6.1, U1.43 (LDO)
/rtd/LTC0.Q3: C2.1, U1.46 (Q3)
/rtd/LTC0.VDD: C4.1, R24.1, U1.2 (V_{DD}), U1.4 (V_{DD}), U1.6 (V_{DD}), U1.8 (V_{DD}), U1.45 (V_{DD})
/rtd/LTC0.VREF: C5.1, U1.13 (V_{REFOUT}), U1.14 (V_{REFP})
/rtd/LTC0.VREFBYP: C3.1, U1.11 (V_{REF_BYP})
/rtd/LTC1.CH1: C34.1, RSENSE2.2, U5.16 (CH1)
/rtd/LTC1.CH4: C37.1, U5.19 (CH4); also elsewhere on the board
/rtd/LTC1.CH6: C39.1, U5.21 (CH6); also elsewhere on the board
/rtd/LTC1.CH8: C41.1, U5.23 (CH8); also elsewhere on the board
/rtd/LTC1.CH9: C35.1, C36.1, C38.1, C40.1, C42.1, C44.1, C46.1, C48.1, C50.1, C52.1, RSENSE2.1, U5.17 (CH2), U5.18 (CH3), U5.20 (CH5), U5.22 (CH7), U5.24 (CH9), U5.26 (CH11), U5.28 (CH13), U5.30 (CH15), U5.32 (CH17), U5.34 (CH19); also elsewhere on the board
/rtd/LTC1.CH10: C43.1, U5.25 (CH10); also elsewhere on the board
/rtd/LTC1.CH12: C45.1, U5.27 (CH12); also elsewhere on the board
/rtd/LTC1.CH14: C47.1, U5.29 (CH14); also elsewhere on the board
/rtd/LTC1.CH16: C49.1, U5.31 (CH16); also elsewhere on the board
/rtd/LTC1.CH18: C51.1, U5.33 (CH18); also elsewhere on the board
/rtd/LTC1.CH20: C53.1, U5.35 (CH20); also elsewhere on the board
/rtd/LTC1.LDO: C33.1, U5.43 (LDO)
/rtd/LTC1.Q3: C28.1, U5.46 (Q3)
/rtd/LTC1.VDD: C31.1, R25.1, U5.2 (V_{DD}), U5.4 (V_{DD}), U5.6 (V_{DD}), U5.8 (V_{DD}), U5.45 (V_{DD})
/rtd/LTC1.VREF: C32.1, U5.13 (V_{REFOUT}), U5.14 (V_{REFP})
/rtd/LTC1.VREFBYP: C30.1, U5.11 (V_{REF_BYP})
GND: C2.2, C3.2, C4.2, C5.2, C6.2, C8.2, C9.2, C10.2, C11.2, C12.2, C13.2, C14.2, C15.2, C16.2, C17.2, C18.2, C19.2, C20.2, C21.2, C22.2, C23.2, C24.2, C25.2, C26.2, C27.2, C28.2, C30.2, C31.2, C32.2, C33.2, C34.2, C35.2, C36.2, C37.2, C38.2, C39.2, C40.2, C41.2, C42.2, C43.2, C44.2, C45.2, C46.2, C47.2, C48.2, C49.2, C50.2, C51.2, C52.2, C53.2, JP4.2 (B), JP5.2 (B), U1.1 (GND), U1.3 (GND), U1.5 (GND), U1.7 (GND), U1.9 (GND), U1.12 (GND), U1.15 (GND), U1.44 (GND), U5.1 (GND), U5.3 (GND), U5.5 (GND), U5.7 (GND), U5.9 (GND), U5.12 (GND), U5.15 (GND), U5.44 (GND); also elsewhere on the board
unnamed: JP4.1 (A), U1.36 (COM)
unnamed: JP5.1 (A), U5.36 (COM)
unnamed: C7.1, U1.48 (Q1)
unnamed: C7.2, U1.47 (Q2)
unnamed: C29.1, U5.48 (Q1)
unnamed: C29.2, U5.47 (Q2)

Notes on the sheet:
Note: Each CH_{n}/CH_{n+1} pair spans a thermistor in the chamber. The thermistors in the chamber are all mutually isolated. There are 17 total thermistors in the chamber, labeled 7-24. The connection from LTC0/LTC1 to the DB-37 connector (on the top-level sheet, see TABLE 1) dictates which thermis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
