thanasipantazides/tate-thermovac/tvac.kicad_pcb

## KiCad design tvac.kicad_pcb (continued)

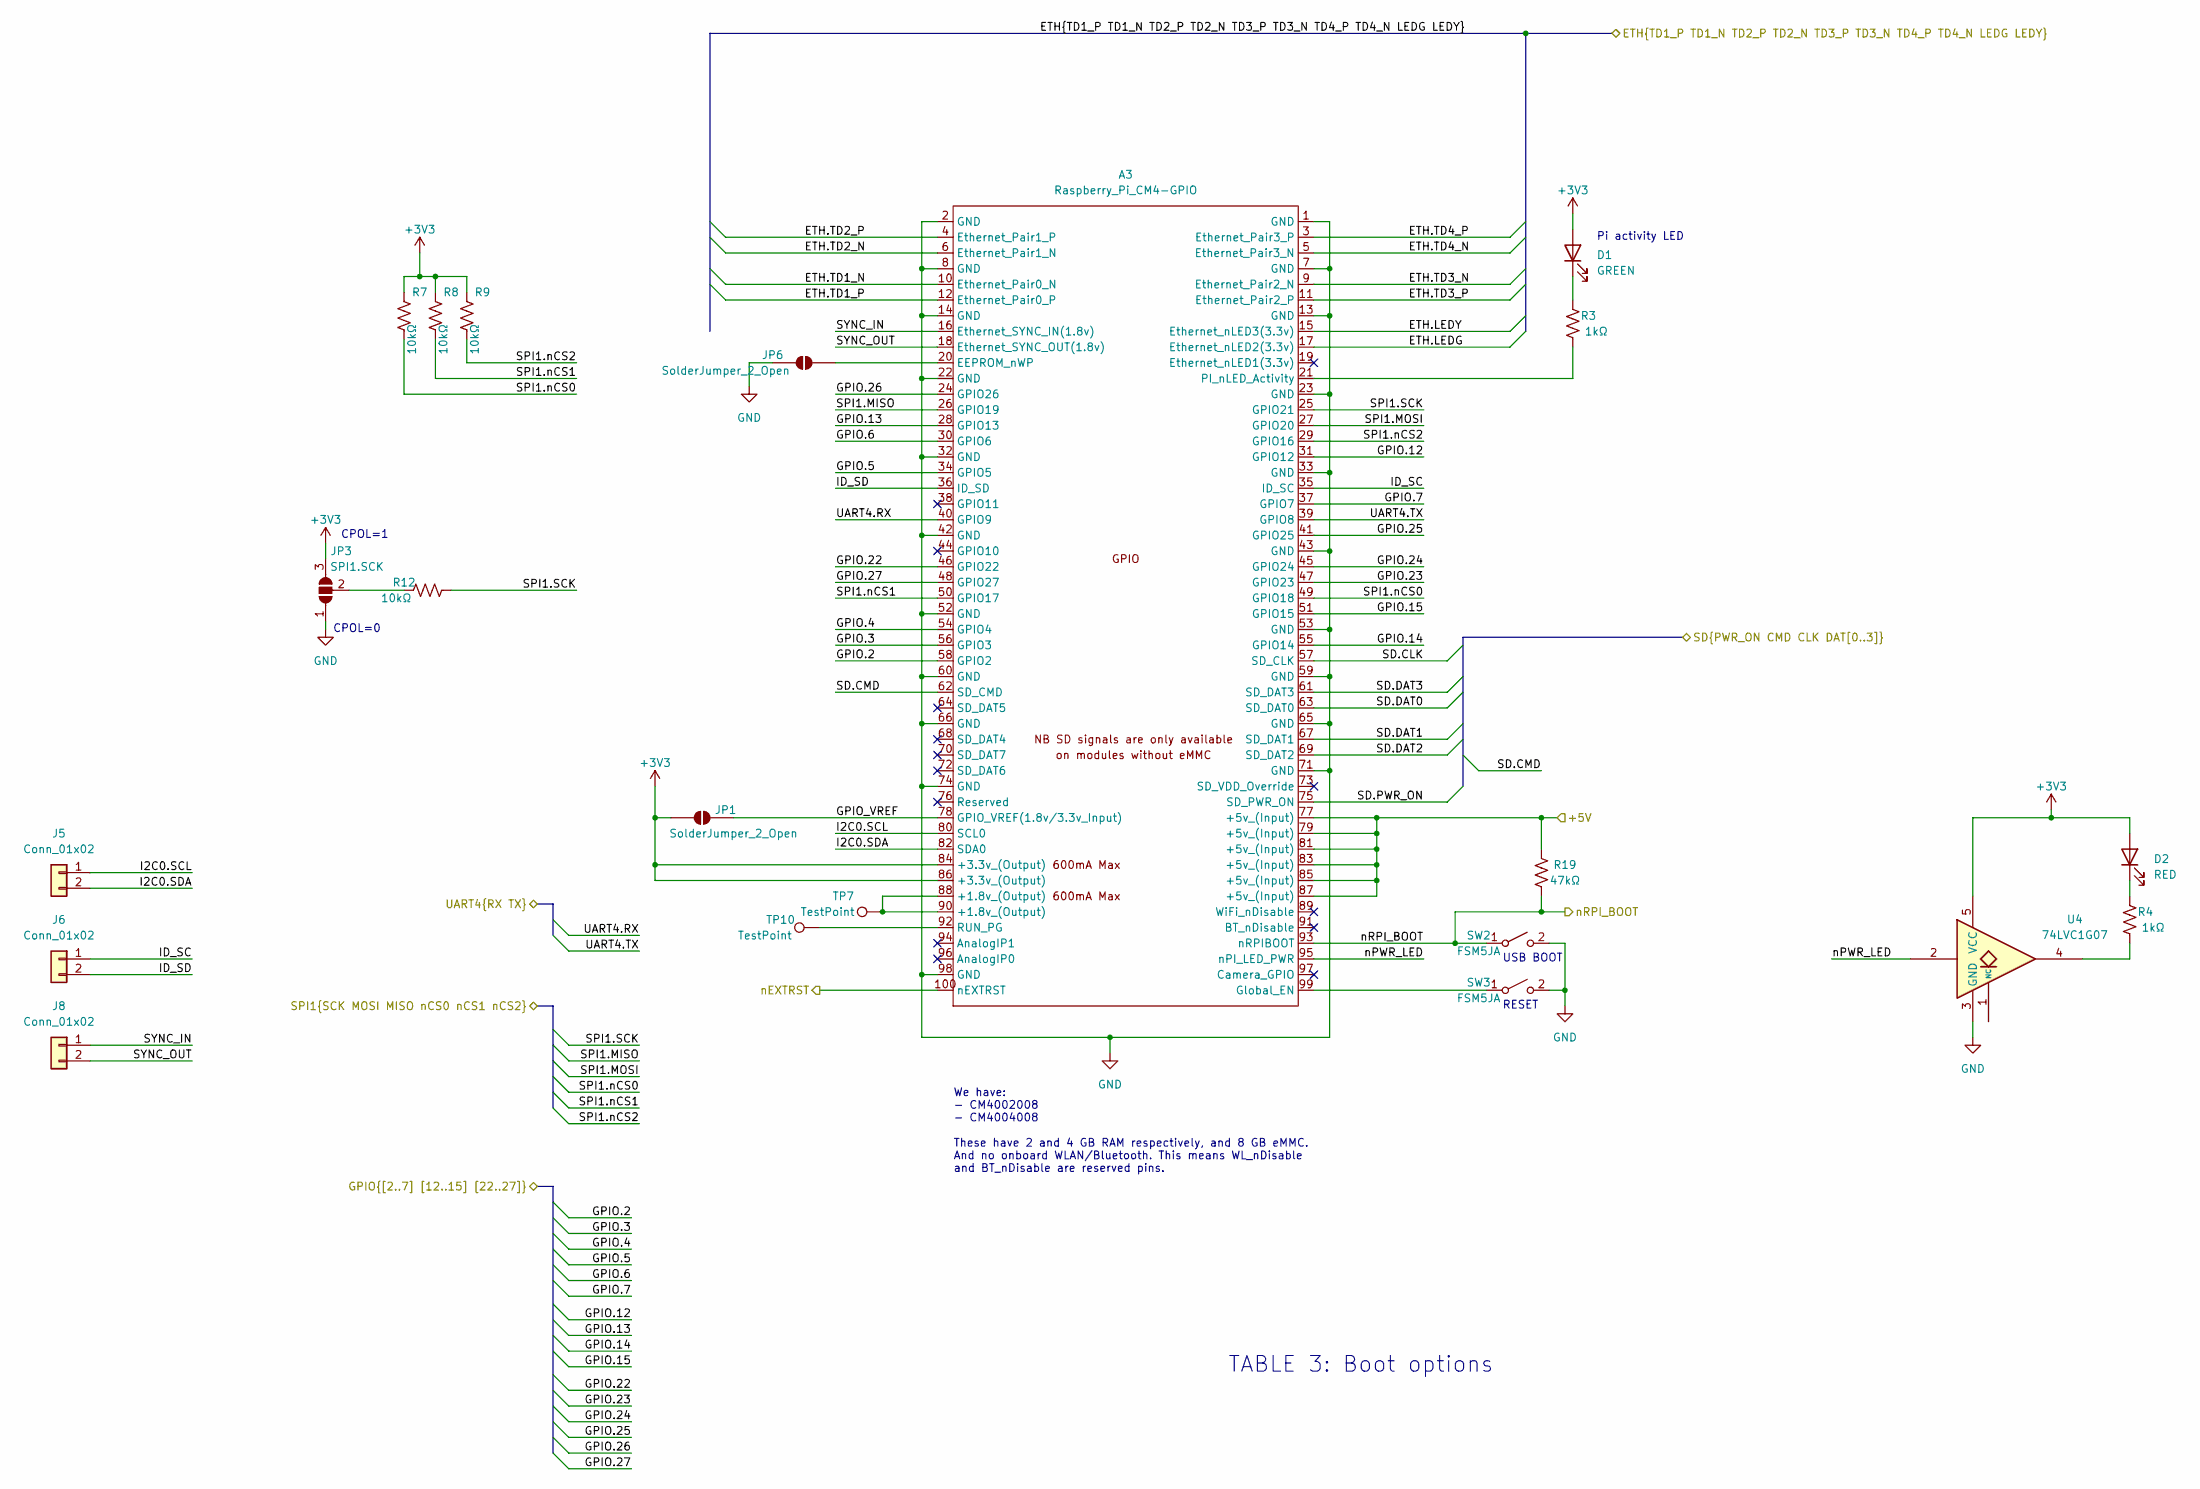
[picture p5: schematic gpio.kicad_sch, the Thermovac Sensation]

Parts:
A3: Raspberry_Pi_CM4-GPIO; Hirose_DF40HC(3.0)-100DS-0.4V_2x50_P0.4mm_RPi_CM4-GPIO
D1: GREEN; LED_1206_3216Metric; Digikey 160-1404-1-ND
D2: RED; LED_1206_3216Metric; Digikey 160-1405-1-ND
J5, J6, J8: Conn_01x02; PinHeader_1x02_P2.54mm_Vertical
JP1, JP6: SolderJumper_2_Open; SolderJumper-2_P1.3mm_Open_RoundedPad1.0x1.5mm
JP3: SPI1.SCK; SolderJumper-3_P1.3mm_Open_RoundedPad1.0x1.5mm
R3, R4: 1kΩ; R_0603_1608Metric
R7, R8, R9, R12: 10kΩ; R_0603_1608Metric
R19: 47kΩ; R_0603_1608Metric
SW2: FSM5JA; SW_DIP_SPSTx01_Slide_9.78x4.72mm_W7.62mm_P2.54mm
SW3: FSM5JA; SW_PUSH_6mm
TP7, TP10: TestPoint; TestPoint_Pad_D2.5mm
U4: 74LVC1G07; SOT-23-5

Connections:
+3V3: A3.84 (+3.3v_(Output)), A3.86 (+3.3v_(Output)), D1.2 (A), D2.2 (A), JP1.1 (A), JP3.3 (B), R7.2, R8.2, R9.2, U4.5 (VCC); also elsewhere on the board
/+5V: A3.77 (+5v_(Input)), A3.79 (+5v_(Input)), A3.81 (+5v_(Input)), A3.83 (+5v_(Input)), A3.85 (+5v_(Input)), A3.87 (+5v_(Input)), R19.2; also elsewhere on the board
/adc/SPI1.MISO: A3.26 (GPIO19); also elsewhere on the board
/adc/SPI1.MOSI: A3.27 (GPIO20); also elsewhere on the board
/adc/SPI1.SCK: A3.25 (GPIO21), R12.1; also elsewhere on the board
/adc/SPI1.nCS0: A3.49 (GPIO18), R7.1; also elsewhere on the board
/adc/SPI1.nCS1: A3.50 (GPIO17), R8.1; also elsewhere on the board
/adc/SPI1.nCS2: A3.29 (GPIO16), R9.1; also elsewhere on the board
/gpio/ETH.LEDG: A3.17 (Ethernet_nLED2(3.3v)); also elsewhere on the board
/gpio/ETH.LEDY: A3.15 (Ethernet_nLED3(3.3v)); also elsewhere on the board
/gpio/ETH.TD1_N: A3.10 (Ethernet_Pair0_N); also elsewhere on the board
/gpio/ETH.TD1_P: A3.12 (Ethernet_Pair0_P); also elsewhere on the board
/gpio/ETH.TD2_N: A3.6 (Ethernet_Pair1_N); also elsewhere on the board
/gpio/ETH.TD2_P: A3.4 (Ethernet_Pair1_P); also elsewhere on the board
/gpio/ETH.TD3_N: A3.9 (Ethernet_Pair2_N); also elsewhere on the board
/gpio/ETH.TD3_P: A3.11 (Ethernet_Pair2_P); also elsewhere on the board
/gpio/ETH.TD4_N: A3.5 (Ethernet_Pair3_N); also elsewhere on the board
/gpio/ETH.TD4_P: A3.3 (Ethernet_Pair3_P); also elsewhere on the board
/gpio/GPIO.2: A3.58 (GPIO2); also elsewhere on the board
/gpio/GPIO.3: A3.56 (GPIO3); also elsewhere on the board
/gpio/GPIO.4: A3.54 (GPIO4); also elsewhere on the board
/gpio/GPIO.5: A3.34 (GPIO5); also elsewhere on the board
/gpio/GPIO.6: A3.30 (GPIO6); also elsewhere on the board
/gpio/GPIO.7: A3.37 (GPIO7); also elsewhere on the board
/gpio/GPIO.12: A3.31 (GPIO12); also elsewhere on the board
/gpio/GPIO.13: A3.28 (GPIO13); also elsewhere on the board
/gpio/GPIO.14: A3.55 (GPIO14); also elsewhere on the board
/gpio/GPIO.15: A3.51 (GPIO15); also elsewhere on the board
/gpio/GPIO.22: A3.46 (GPIO22); also elsewhere on the board
/gpio/GPIO.23: A3.47 (GPIO23); also elsewhere on the board
/gpio/GPIO.24: A3.45 (GPIO24); also elsewhere on the board
/gpio/GPIO.25: A3.41 (GPIO25); also elsewhere on the board
/gpio/GPIO.26: A3.24 (GPIO26); also elsewhere on the board
/gpio/GPIO.27: A3.48 (GPIO27); also elsewhere on the board
/gpio/GPIO_VREF: A3.78 (GPIO_VREF(1.8v/3.3v_Input)), JP1.2 (B)
/gpio/I2C0.SCL: A3.80 (SCL0), J5.1
/gpio/I2C0.SDA: A3.82 (SDA0), J5.2
/gpio/ID_SC: A3.35 (ID_SC), J6.1
/gpio/ID_SD: A3.36 (ID_SD), J6.2
/gpio/SD.CLK: A3.57 (SD_CLK); also elsewhere on the board
/gpio/SD.CMD: A3.62 (SD_CMD); also elsewhere on the board
/gpio/SD.DAT0: A3.63 (SD_DAT0); also elsewhere on the board
/gpio/SD.DAT1: A3.67 (SD_DAT1); also elsewhere on the board
/gpio/SD.DAT2: A3.69 (SD_DAT2); also elsewhere on the board
/gpio/SD.DAT3: A3.61 (SD_DAT3); also elsewhere on the board
/gpio/SD.PWR_ON: A3.75 (SD_PWR_ON)
/gpio/SYNC_IN: A3.16 (Ethernet_SYNC_IN(1.8v)), J8.1
/gpio/SYNC_OUT: A3.18 (Ethernet_SYNC_OUT(1.8v)), J8.2
/gpio/UART4.RX: A3.40 (GPIO9); also elsewhere on the board
/gpio/UART4.TX: A3.39 (GPIO8); also elsewhere on the board
/gpio/nEXTRST: A3.100 (nEXTRST); also elsewhere on the board
/gpio/nPWR_LED: A3.95 (nPI_LED_PWR), U4.2
/gpio/nRPI_BOOT: A3.93 (nRPIBOOT), R19.1, SW2.1 (A); also elsewhere on the board
GND: A3.1 (GND), A3.2 (GND), A3.7 (GND), A3.8 (GND), A3.13 (GND), A3.14 (GND), A3.22 (GND), A3.23 (GND), A3.32 (GND), A3.33 (GND), A3.42 (GND), A3.43 (GND), A3.52 (GND), A3.53 (GND), A3.59 (GND), A3.60 (GND), A3.65 (GND), A3.66 (GND), A3.71 (GND), A3.74 (GND), A3.98 (GND), JP3.1 (A), JP6.1 (A), SW2.2 (B), SW3.2 (B), U4.3 (GND); also elsewhere on the board
unnamed: A3.88 (+1.8v_(Output)), A3.90 (+1.8v_(Output)), TP7.1 (1_1)
unnamed: A3.20 (EEPROM_nWP), JP6.2 (B)
unnamed: A3.99 (Global_EN), SW3.1 (A)
unnamed: A3.21 (PI_nLED_Activity), R3.1
unnamed: A3.92 (RUN_PG), TP10.1 (1_1)
unnamed: D1.1 (K), R3.2
unnamed: D2.1 (K), R4.2
unnamed: JP3.2 (C), R12.2
unnamed: R4.1, U4.4

Notes on the sheet:
TABLE 3: Boot options
CPOL=1
RESET
USB BOOT
We have: - CM4002008 - CM4004008 These have 2 and 4 GB RAM respectively, and 8 GB eMMC. And no onboard WLAN/Bluetooth. This means WL_nDisable and BT_nDisable are reserved pins.
Pi activity LED
CPOL=0

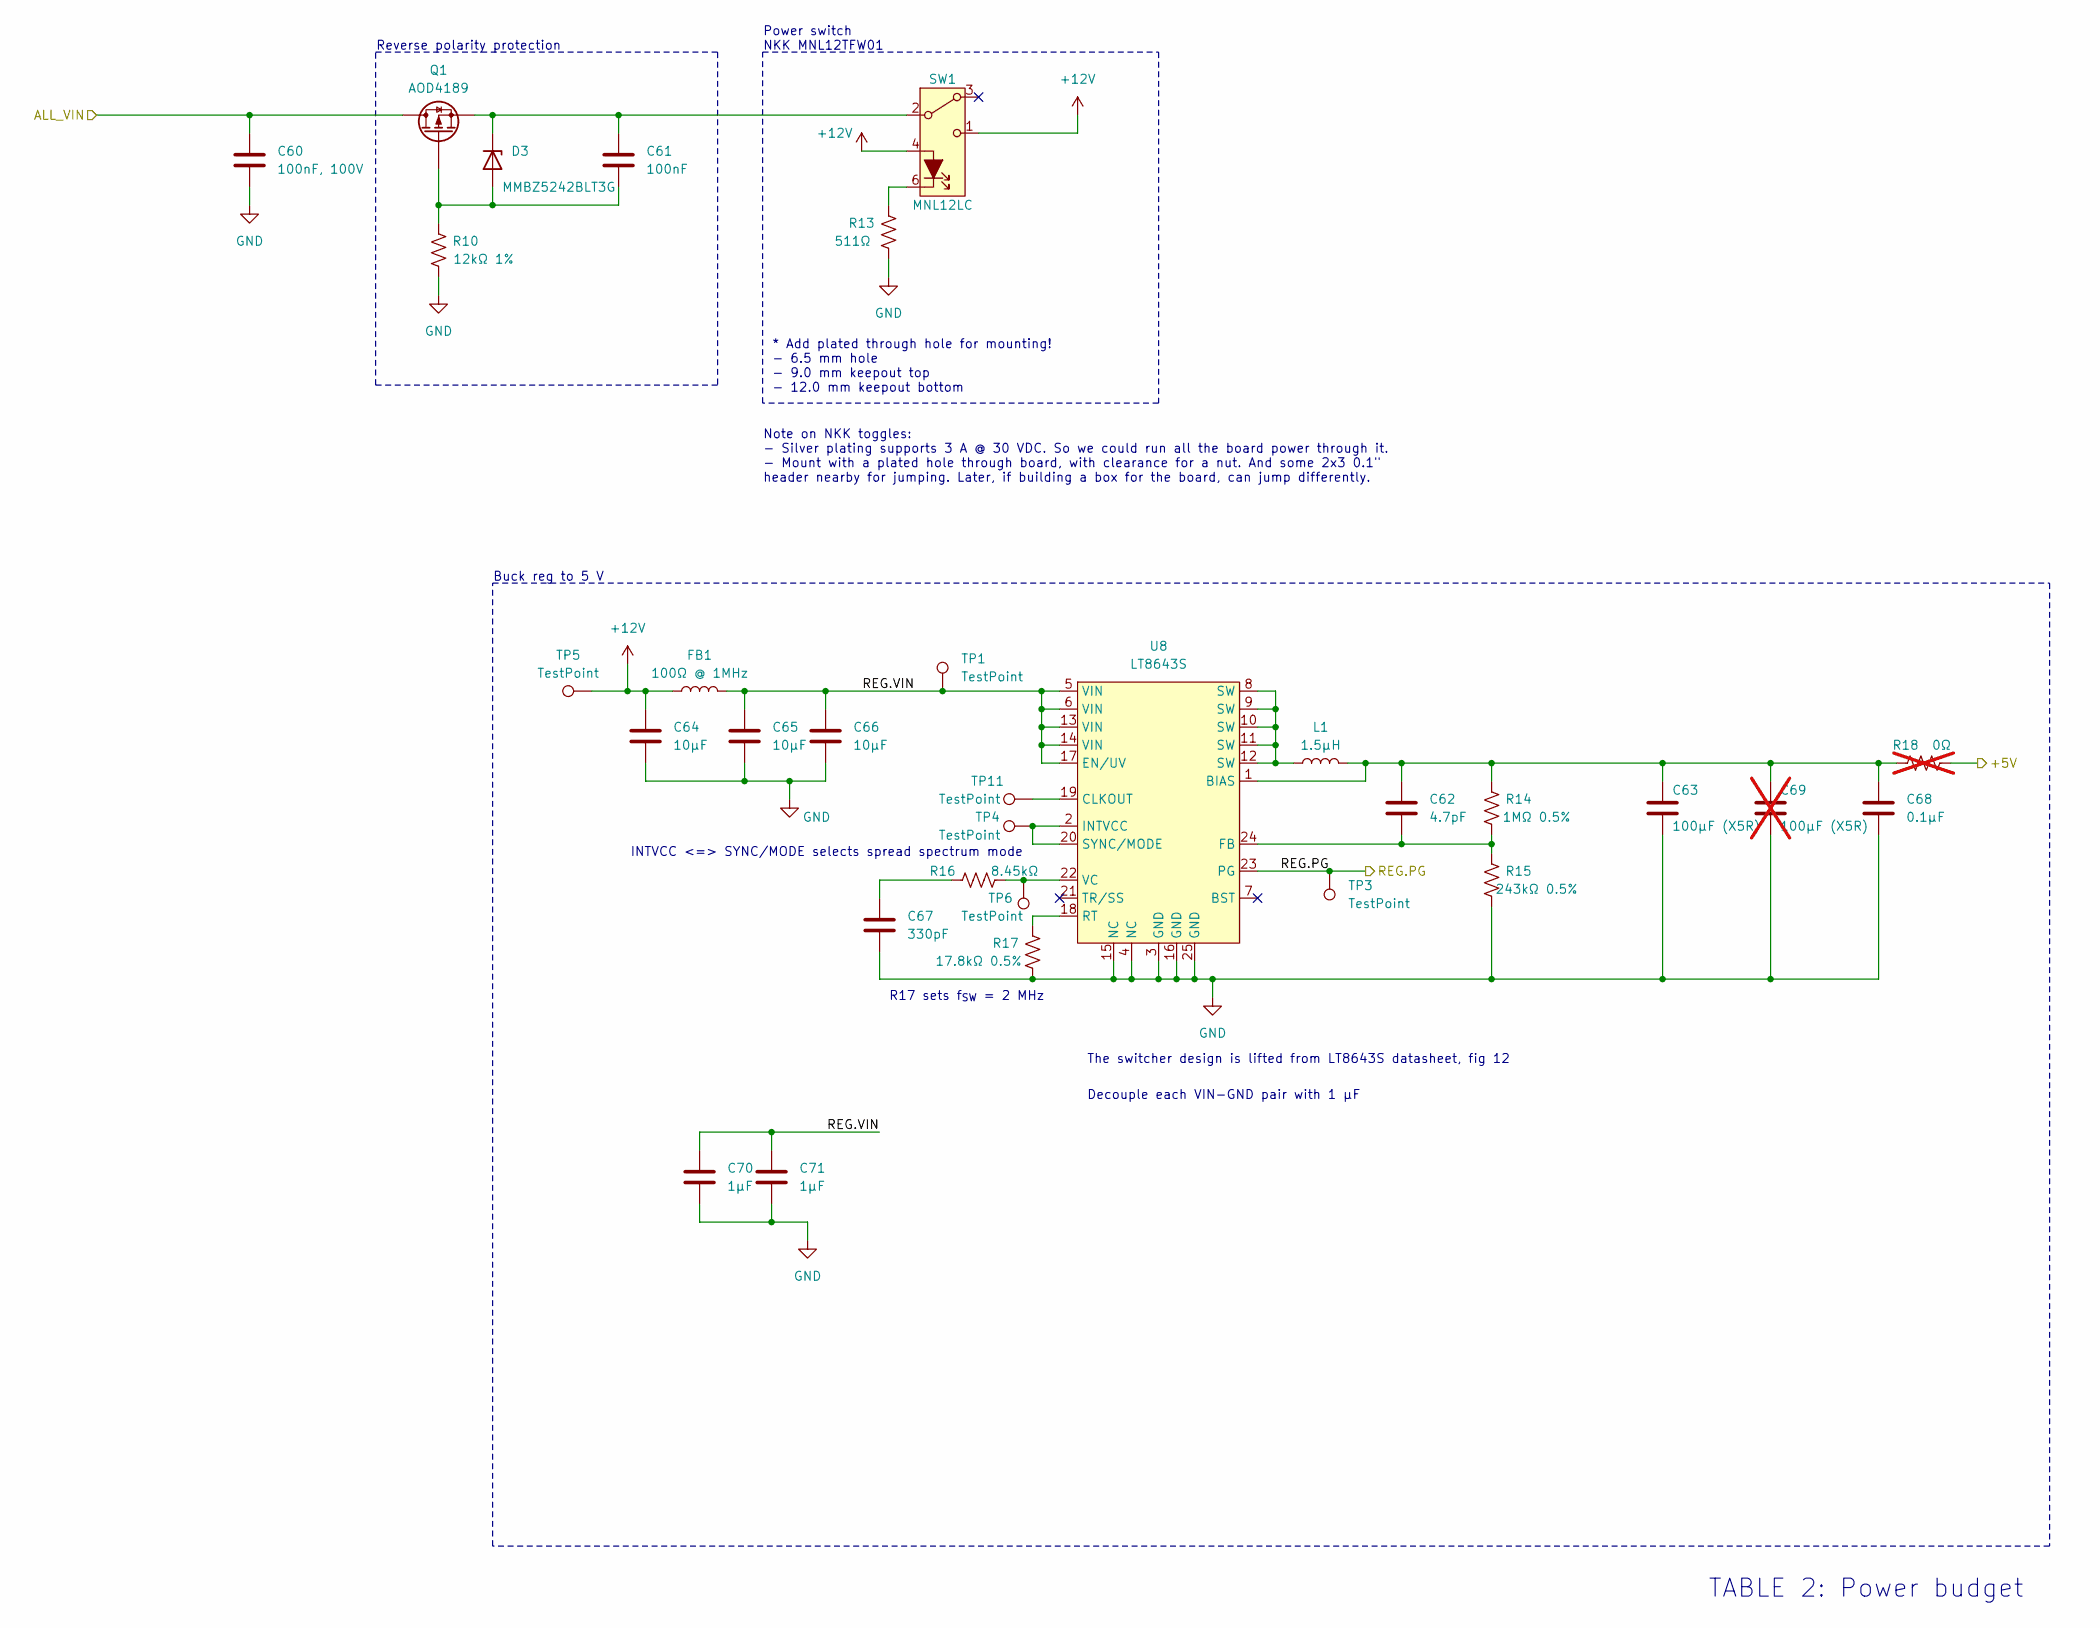
[picture p6: schematic power.kicad_sch, the Thermovac Sensation]

Parts:
C60: 100nF, 100V; C_1210_3225Metric
C61: 100nF; C_0603_1608Metric
C62: 4.7pF; C_0603_1608Metric
C63: 100µF (X5R); C_1210_3225Metric
C64, C65, C66: 10µF; C_1210_3225Metric
C67: 330pF; C_0603_1608Metric
C68: 0.1µF; C_0603_1608Metric
C69: 100µF (X5R); C_1210_3225Metric; not fitted
C70, C71: 1µF; C_0603_1608Metric
D3: MMBZ5242BLT3G; SOT-23; Digikey MMBZ5242BLT3GOSCT-ND
FB1: 100Ω @ 1MHz; C_1812_4532Metric; Digikey 732-3431-1-ND
L1: 1.5µH; L_Wuerth_HCI-1365
Q1: AOD4189; TO-252-2; Digikey 785-1351-1-ND
R10: 12kΩ 1%; R_0603_1608Metric
R13: 511Ω; R_0603_1608Metric
R14: 1MΩ 0.5%; R_0603_1608Metric
R15: 243kΩ 0.5%; R_0603_1608Metric
R16: 8.45kΩ; R_0603_1608Metric
R17: 17.8kΩ 0.5%; R_0603_1608Metric
R18: 0Ω; R_1210_3225Metric; not fitted
SW1: MNL12LC; PinSocket_2x03_P2.54mm_Vertical
TP1, TP3, TP4, TP5, TP6, TP11: TestPoint; TestPoint_Pad_D2.5mm
U8: LT8643S; QFN-24-1EP_4x4mm_P0.5mm_EP2.75x2.75mm

Connections:
+12V: C64.1, FB1.1, SW1.1 (C), SW1.4 (KR), TP5.1 (1_1)
/+5V: R18.2; also elsewhere on the board
/power/ALL_VIN: C60.1, Q1.D; also elsewhere on the board
/power/REG.PG: TP3.1 (1_1), U8.23 (PG)
/power/REG.VIN: C65.1, C66.1, C70.1, C71.1, FB1.2, TP1.1 (1_1), U8.5 (VIN), U8.6 (VIN), U8.13 (VIN), U8.14 (VIN), U8.17 (EN/UV)
GND: C60.2, C63.2, C64.2, C65.2, C66.2, C67.2, C68.2, C69.2, C70.2, C71.2, R10.1, R13.1, R15.1, R17.2, U8.3 (GND), U8.4 (NC), U8.15 (NC), U8.16 (GND), U8.25 (GND); also elsewhere on the board
unnamed: C67.1, R16.2
unnamed: C61.2, D3.1 (A), Q1.G, R10.2
unnamed: C61.1, D3.3 (K), Q1.S, SW1.2 (B)
unnamed: L1.1, U8.8 (SW), U8.9 (SW), U8.10 (SW), U8.11 (SW), U8.12 (SW)
unnamed: R13.2, SW1.6 (KG)
unnamed: C62.1, C63.1, C68.1, C69.1, L1.2, R14.2, R18.1, U8.1 (BIAS)
unnamed: TP11.1 (1_1), U8.19 (CLKOUT)
unnamed: C62.2, R14.1, R15.2, U8.24 (FB)
unnamed: TP4.1 (1_1), U8.2 (INTVCC), U8.20 (SYNC/MODE)
unnamed: R17.1, U8.18 (RT)
unnamed: R16.1, TP6.1 (1_1), U8.22 (VC)

Notes on the sheet:
TABLE 2: Power budget
INTVCC <=> SYNC/MODE selects spread spectrum mode
Power switch NKK MNL12TFW01
Note on NKK toggles: - Silver plating supports 3 A @ 30 VDC. So we could run all the board power through it. - Mount with a plated hole through board, with clearance for a nut. And some 2x3 0.1" header nearby for jumping. Later, if building a box for the board, can jump differently.
Buck reg to 5 V
R17 sets f_{SW} = 2 MHz
Decouple each VIN-GND pair with 1 µF
The switcher design is lifted from LT8643S datasheet, fig 12
* Add plated through hole for mounting! - 6.5 mm hole - 9.0 mm keepout top - 12.0 mm keepout bottom
Reverse polarity protection

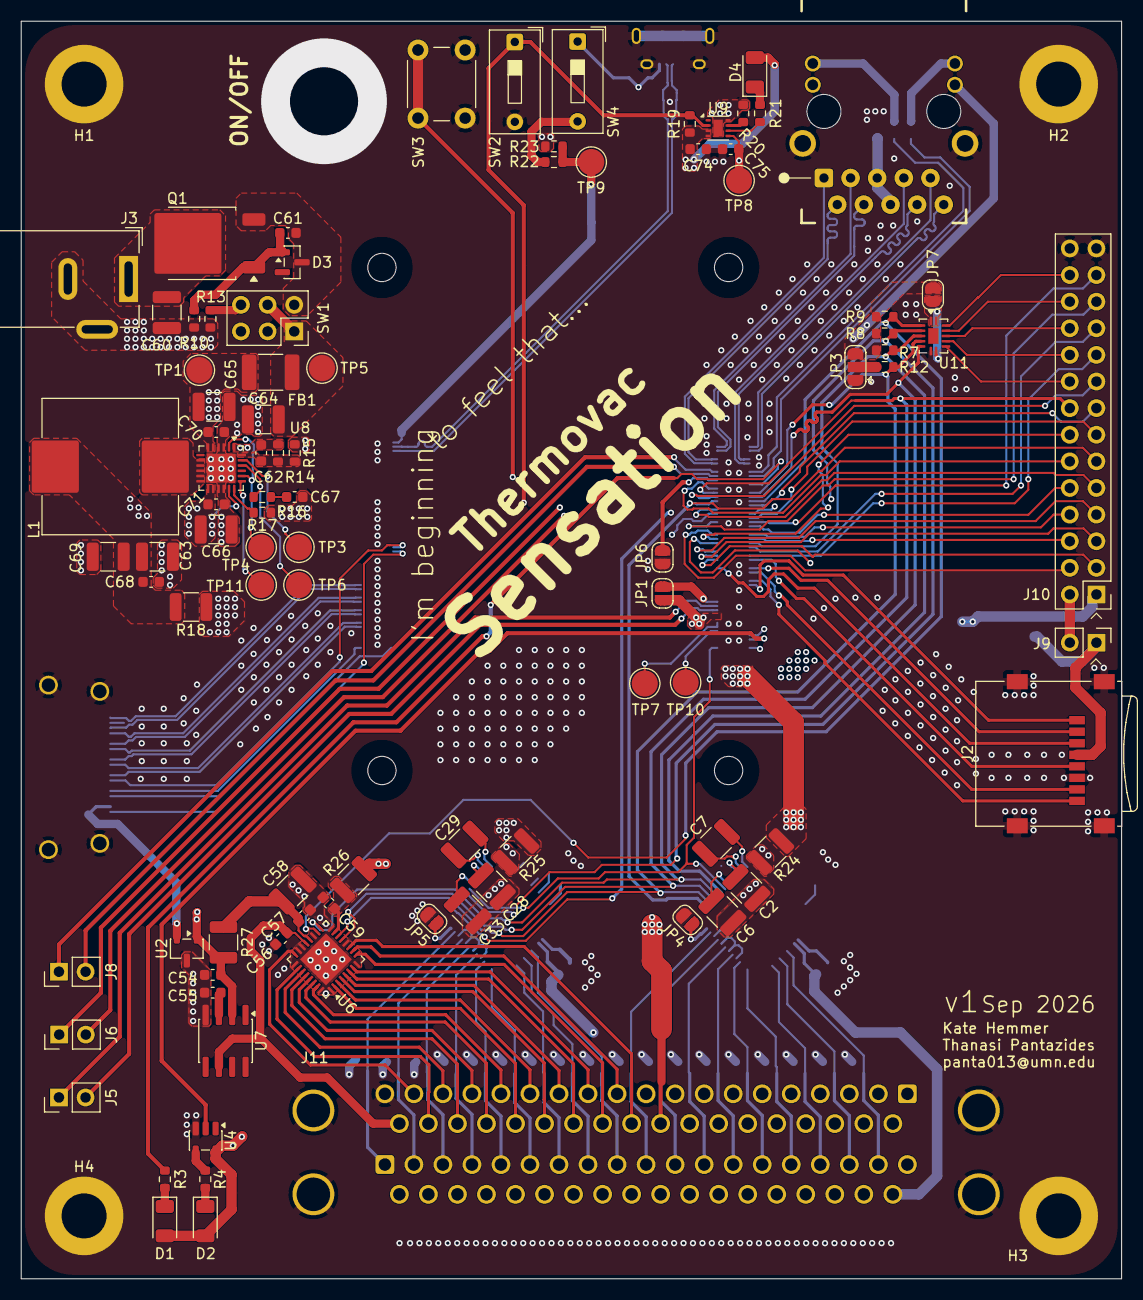
[picture p7: board tvac.kicad_pcb from above]

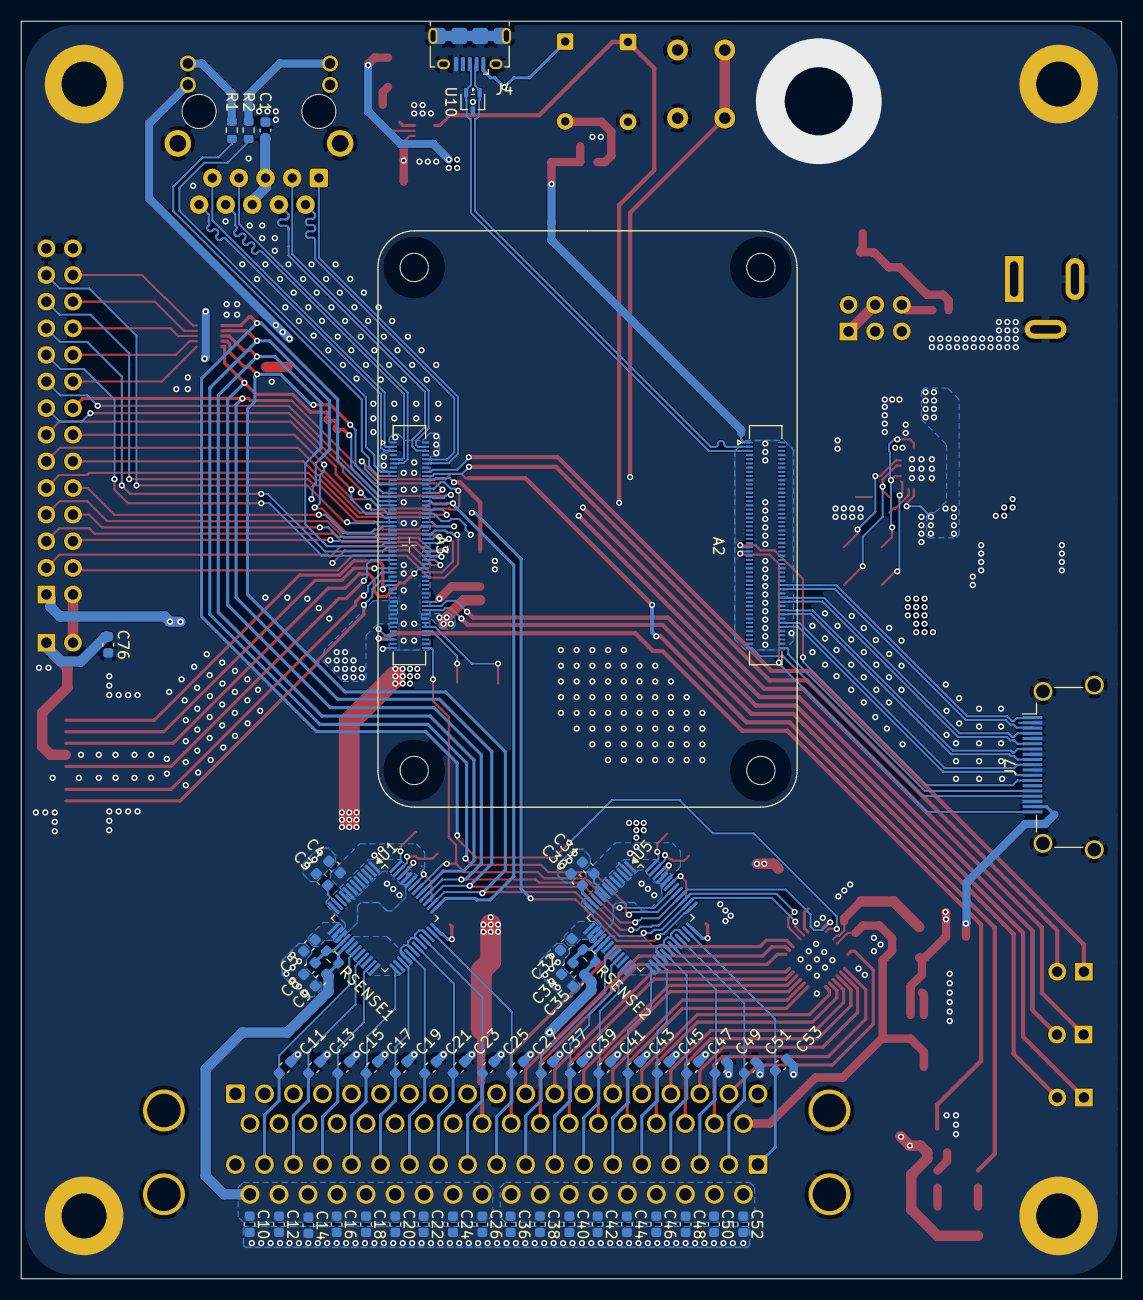
[picture p8: board tvac.kicad_pcb from below]

Board: 4 copper layers, 105.0 x 120.0 mm, 154 parts (59 on the bottom side), 166 nets.
