thanasipantazides/tate-thermovac/(commit log)

2026-11-06 notes on board bringup and RPi boot
2026-11-06 tweaks to board display
